LuisErnie/Pico-Bot/README.md

# Pico-Bot
Raspberry Pi RP2040 Based Robotics Controller
