LuisErnie/Pico-Bot/KiCAD design files/QR.png

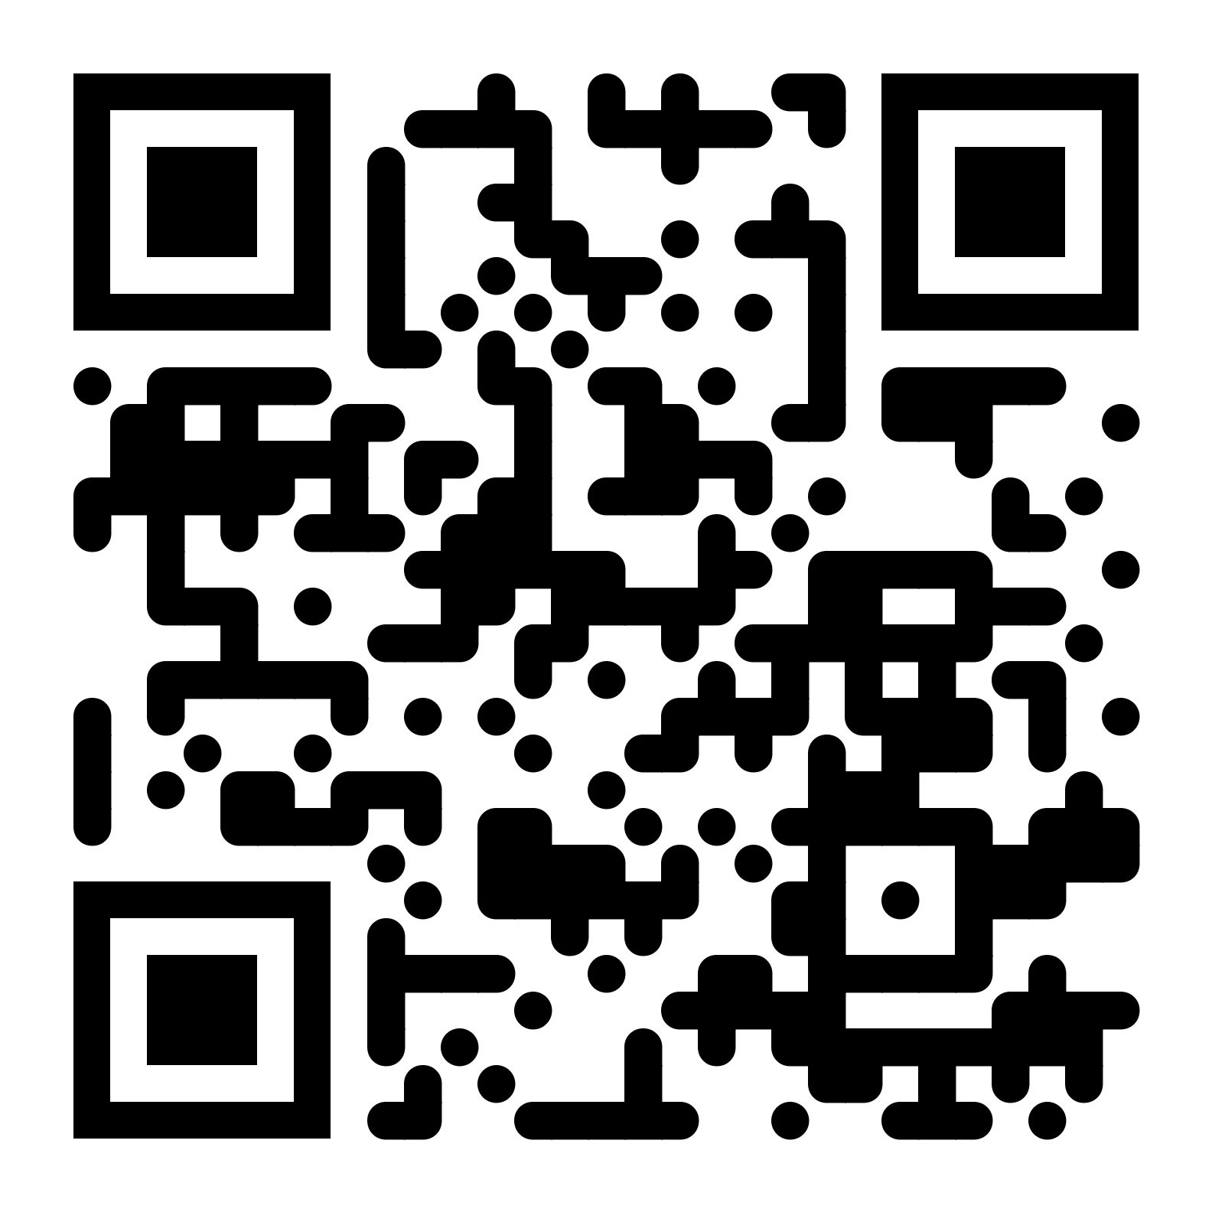
KiCAD design files/QR.png
