LuisErnie/Pico-Bot/KiCAD design files/Table 2.png

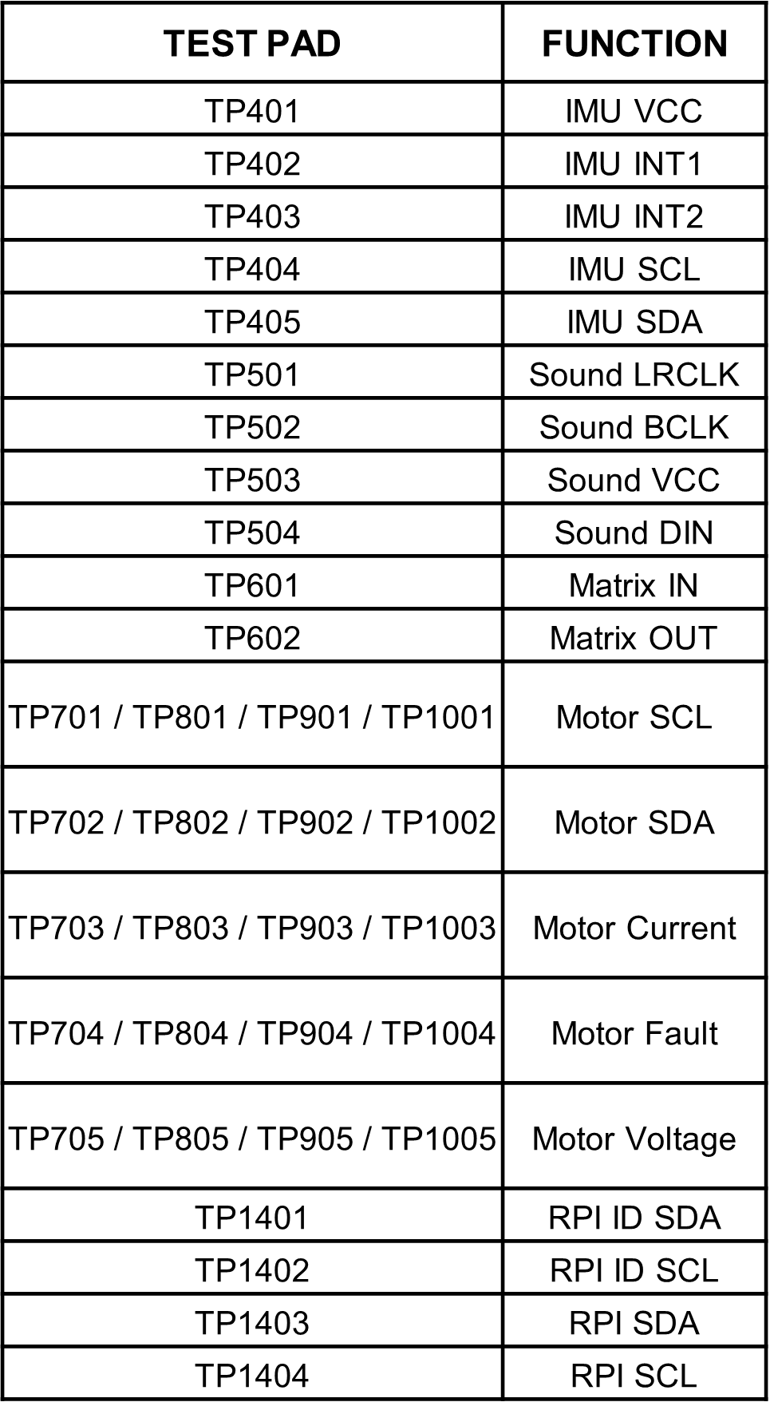
KiCAD design files/Table 2.png
