LuisErnie/Pico-Bot/KiCAD design files/Table.png

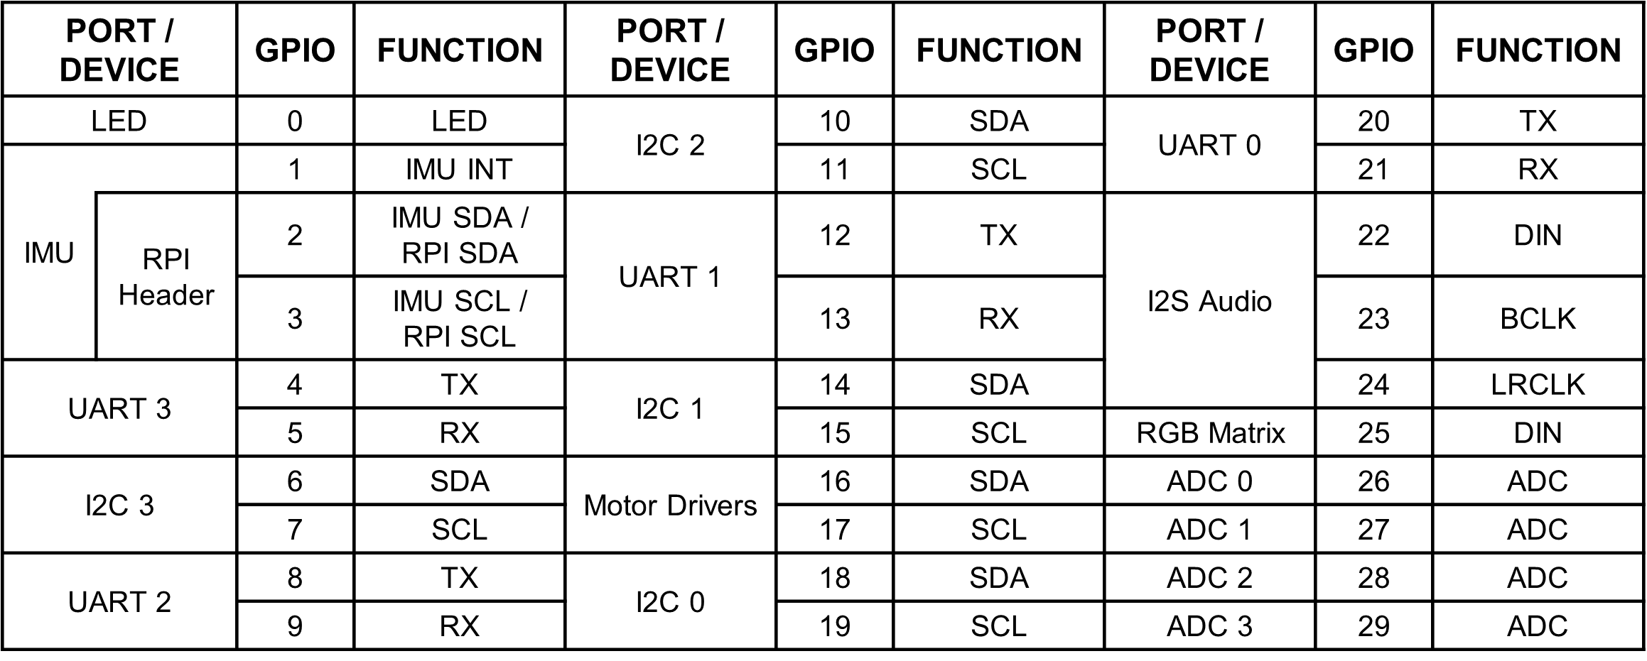
KiCAD design files/Table.png
