LuisErnie/Pico-Bot/KiCAD design files/BOM.xlsx

Customer Part Number(optional) | Manufacture Part Number | Qty | Qty TT | Value | Cmp name | Footprint | Description
J202, | XT60 | 1 | 5 | XT60-M | XT60-M | SnapEDA Library:AMASS_XT60-M
Y301, | X503212MSB2GI | 1 | 5 | Crystal 12MHz | Crystal | Crystal:Crystal_SMD_5032-2Pin_5.0x3.2mm_HandSoldering | Two pin crystal
U301, | USBLC6-2P6 | 1 | 5 | USBLC6-2P6 | USBLC6-2P6 | Package_TO_SOT_SMD:SOT-666 | Very low capacitance ESD protection diode, 2 data-line, SOT-666
J301, | TYPEC-304A-ACP16L | 1 | 5 | USB_C_Receptacle_USB2.0 | USB_C_Receptacle_USB2.0 | Connector_USB:USB_C_Receptacle_XKB_U262-16XN-4BVC11 | USB 2.0-only Type-C Receptacle connector
F202, F203, F204, F205, | SMD1812-300C-16V | 4 | 20 | Polyfuse | Polyfuse | Fuse:Fuse_1812_4532Metric | Resettable fuse, polymeric positive temperature coefficient
F201 | SMD1812-110C-16V | 1 | 5 | Polyfuse | Polyfuse | Fuse:Fuse_1812_4532Metric | Resettable fuse, polymeric positive temperature coefficient
R205, | RC0603FR-071M91L | 1 | 5 | R_UP | R_US | Resistor_SMD:R_0603_1608Metric_Pad0.98x0.95mm_HandSolder | Resistor, US symbol
R717, R817, R917, R1017, | RC-02W3302FT | 4 | 20 | 33k | R_US | Resistor_SMD:R_0402_1005Metric_Pad0.72x0.64mm_HandSolder | Resistor, US symbol
R706, R806, R906, R1006, | RC-02W3300FT | 4 | 20 | 330E | R_US | Resistor_SMD:R_0402_1005Metric_Pad0.72x0.64mm_HandSolder | Resistor, US symbol
J1401, | PH-00650 | 1 | 5 | Raspberry_Pi_2_3 | Raspberry_Pi_2_3 | Connector_PinHeader_2.54mm:PinHeader_2x20_P2.54mm_Vertical_SMD | expansion header for Raspberry Pi 2 & 3
D301, D302, D303, D304, D701, D702, D703, D704, D801, D802, D803, D804, D901, D902, D903, D904, D1001, D1002, D1003, D1004, | PESD3V3L1BA,115 | 20 | 100 | PESD3V3L1BA | D_TVS | Diode_SMD:D_SOD-323 | Bidirectional transient-voltage-suppression diode
U703, U803, U903, U1003, U1101, U1102, U1103, U1104, U1201, U1202, U1203, U1204, | MCP6001T-I/OT | 12 | 60 | MCP6001x-LT | MCP6001x-LT | Package_TO_SOT_SMD:SOT-23-5_HandSoldering | 1 MHz, Low-Power Op Amp, SC-70-5
U201, U202, | LTC4412ES6#TRPBF | 2 | 10 | LTC4412xS6 | LTC4412xS6 | Package_TO_SOT_SMD:TSOT-23-6 | Low Loss PowerPath Controller, TSOT-23-6
J1317, J1318, J1319, J1320, | KF141R-2.54-2P | 4 | 8 | 691402910002B | 691402910002B | SnapEDA Library:691402910002B
C303, C311, C313, C315, | GRM155R61E225KE11D | 4 | 20 | 2.2uF | C | Capacitor_SMD:C_0402_1005Metric_Pad0.74x0.62mm_HandSolder | Unpolarized capacitor
R301, R302, | FRC0402F5101TS | 2 | 10 | 5k1 | R_US | Resistor_SMD:R_0402_1005Metric_Pad0.72x0.64mm_HandSolder | Resistor, US symbol
R308, R309, R310, R701, R702, R705, R801, R802, R805, R901, R902, R903, R1001, R1002, R1003, | FRC0402F49R9TS | 15 | 75 | 50E | R_US | Resistor_SMD:R_0402_1005Metric_Pad0.72x0.64mm_HandSolder | Resistor, US symbol
R202, R203, | FRC0402F4703TS | 2 | 10 | 470k | R_US | Resistor_SMD:R_0402_1005Metric_Pad0.72x0.64mm_HandSolder | Resistor, US symbol
R1401, R1402, | FRC0402F3901TS | 2 | 10 | 3k9 | R_US | Resistor_SMD:R_0402_1005Metric_Pad0.72x0.64mm_HandSolder | Resistor, US symbol
R303, | FRC0402F2000TS | 1 | 5 | 200E | R_US | Resistor_SMD:R_0402_1005Metric_Pad0.72x0.64mm_HandSolder | Resistor, US symbol
R305, | FRC0402F1R00TS | 1 | 5 | 1E | R_US | Resistor_SMD:R_0402_1005Metric_Pad0.72x0.64mm_HandSolder | Resistor, US symbol
R501, | FRC0402F1004TS | 1 | 5 | 1M | R_US | Resistor_SMD:R_0402_1005Metric_Pad0.72x0.64mm_HandSolder | Resistor, US symbol
R502, R506, R714, R718, R814, R818, R914, R918, R1014, R1018, | FRC0402F1003TS | 10 | 50 | 100k | R_US | Resistor_SMD:R_0402_1005Metric_Pad0.72x0.64mm_HandSolder | Resistor, US symbol
R304, R313, R401, R402, R403, R703, R704, R709, R710, R711, R712, R713, R716, R719, R720, R803, R804, R809, R810, R811, R812, R813, R816, R819, R820, R904, R905, R909, R910, R911, R912, R913, R916, R919, R920, R1004, R1005, R1009, R1010, R1011, R1012, R1013, R1016, R1019, R1020, | FRC0402F1002TS | 45 | 225 | 10k | R_US | Resistor_SMD:R_0402_1005Metric_Pad0.72x0.64mm_HandSolder | Resistor, US symbol
R201, R312, R314, R315, R1403, | FRC0402F1001TS | 5 | 25 | 1k | R_US | Resistor_SMD:R_0402_1005Metric_Pad0.72x0.64mm_HandSolder | Resistor, US symbol
R404, R405, R503, R504, R505, R707, R708, R715, R807, R808, R815, R907, R908, R915, R1007, R1008, R1015, R1101, R1102, R1103, R1104, R1201, R1202, R1203, R1204, | FRC0402F0000TS | 25 | 125 | 0E | R_US | Resistor_SMD:R_0402_1005Metric_Pad0.72x0.64mm_HandSolder | Resistor, US symbol
FB202, | FBMA-11-453215-900A60T | 1 | 5 | FerriteBead (7427932) | FerriteBead | Inductor_SMD:L_1812_4532Metric | Ferrite bead
S201, | EG1213 | 1 | 5 | EG1213 | EG1213 | SnapEDA Library:SW_EG1213
C203, | EEEFC1E220AP | 1 | 5 | 22uF 10V | C_Polarized_US | Capacitor_SMD:CP_Elec_4x5.4 | Polarized capacitor, US symbol
C201, C202, | EEE1VA100WAR | 6 | 30 | 10uF 25V | C_Polarized_US | Capacitor_SMD:CP_Elec_4x5.4 | Polarized capacitor, US symbol
J201, | DC-050-25A | 1 | 5 | Barrel_Jack_Switch | Barrel_Jack_Switch | Connector_BarrelJack:BarrelJack_CLIFF_FC681465S_SMT_Horizontal | DC Barrel Jack with an internal switch
J102, | CS-1165SDIG-1*3 | 1 | 5 | Conn_01x03_Female | Conn_01x03_Female | Connector_PinSocket_2.54mm:PinSocket_1x03_P2.54mm_Vertical | Generic connector, single row, 01x03, script generated (kicad-library-utils/schlib/autogen/connector/)
L301, | CMF3216F-900M-2P-T | 1 | 5 | EMTEK CMF3216F-900M-2P-T | L_Iron_Coupled | SnapEDA Library:FIL_SRF3216-222Y | Coupled inductor with iron core
C501, | CL05A106MP5NUNC | 1 | 5 | 10uF | C | Capacitor_SMD:C_0402_1005Metric_Pad0.74x0.62mm_HandSolder | Unpolarized capacitor
FB501, FB502, FB701, FB801, FB901, FB1001, FB1101, FB1102, FB1103, FB1104, FB1201, FB1202, FB1203, FB1204, | CBW201209U101T | 14 | 70 | FerriteBead | FerriteBead | Inductor_SMD:L_0805_2012Metric | Ferrite bead
FB201, | BCMS453215A7006A | 1 | 5 | FerriteBead (742792510) | FerriteBead | Inductor_SMD:L_1812_4532Metric | Ferrite bead
Q201, Q202, | AO4805 | 2 | 10 | SI4925BDY | SI4925BDY | SnapEDA Library:SO-8
J101, | 12251103CNG0S115001 | 1 | 5 | Conn_01x03_Male | Conn_01x03_Male | Connector_PinHeader_2.54mm:PinHeader_1x03_P2.54mm_Vertical | Generic connector, single row, 01x03, script generated (kicad-library-utils/schlib/autogen/connector/)
R207, | 0603WAF3404T5E | 1 | 5 | R_DOWN | R_US | Resistor_SMD:R_0603_1608Metric_Pad0.98x0.95mm_HandSolder | Resistor, US symbol
R306, R307, | 0402WGF270JTCE | 2 | 10 | 27E | R_US | Resistor_SMD:R_0402_1005Metric_Pad0.72x0.64mm_HandSolder | Resistor, US symbol
R721, R821, R921, R1021, | 0402WGF200LTCE | 4 | 20 | 0.2E | R_US | Resistor_SMD:R_0402_1005Metric_Pad0.72x0.64mm_HandSolder | Resistor, US symbol
C503, C504, | 0402N221J500CT | 2 | 10 | 220pF | C | Capacitor_SMD:C_0402_1005Metric_Pad0.74x0.62mm_HandSolder | Unpolarized capacitor
C316, C317, | 0402N150F500CT | 2 | 10 | 15pF | C | Capacitor_SMD:C_0402_1005Metric_Pad0.74x0.62mm_HandSolder | Unpolarized capacitor
C301, C302, C304, C305, C306, C307, C308, C309, C310, C312, C314, C401, C402, C502, C601, C602, C603, C604, C605, C606, C607, C608, C609, C610, C611, C612, C613, C614, C615, C616, C617, C618, C619, C620, C621, C622, C623, C624, C625, C701, C704, C705, C706, C708, C801, C804, C805, C806, C808, C901, C904, C905, C906, C908, C1001, C1004, C1005, C1006, C1008, C1101, C1102, C1105, C1108, C1201, C1202, C1205, C1208, C1401, | 0402B104J160CT | 68 | 340 | 0.1uF | C | Capacitor_SMD:C_0402_1005Metric_Pad0.74x0.62mm_HandSolder | Unpolarized capacitor
C702, C802, C902, C1002, | 0402B103J500CT | 4 | 20 | 10nF | C | Capacitor_SMD:C_0402_1005Metric_Pad0.74x0.62mm_HandSolder | Unpolarized capacitor
C709, C809, C909, C1009, | 0402B102J500CT | 4 | 20 | 1000pF | C | Capacitor_SMD:C_0402_1005Metric_Pad0.74x0.62mm_HandSolder | Unpolarized capacitor
C707, C807, C907, C1007, C1103, C1104, C1106, C1107, C1203, C1204, C1206, C1207, | - | 12 | 0 | NP | C | Capacitor_SMD:C_0603_1608Metric_Pad1.08x0.95mm_HandSolder | Unpolarized capacitor
D201, D305, | - | 2 | 0 | LED | LED | LED_SMD:LED_0805_2012Metric | Light emitting diode
D601, D602, D603, D604, D605, D606, D607, D608, D609, D610, D611, D612, D613, D614, D615, D616, D617, D618, D619, D620, D621, D622, D623, D624, D625, | - | 25 | 0 | WS2812B | WS2812B | LED_SMD:LED_WS2812B_PLCC4_5.0x5.0mm_P3.2mm | RGB LED with integrated controller
J1301, J1302, J1303, J1304, J1305, J1306, J1307, J1308, J1309, J1310, J1311, J1312, J1313, J1314, J1315, J1316, | - | 16 | 0 | 114020164 | 114020164 | 114020164:114020164
J501, | - | 1 | 0 | Conn_01x02_Male | Conn_01x02_Male | Connector_JST:JST_XH_B2B-XH-A_1x02_P2.50mm_Vertical | Generic connector, single row, 01x02, script generated (kicad-library-utils/schlib/autogen/connector/)
SW301, SW302, | - | 2 | 0 | SW_SPST | SW_SPST | Button_Switch_SMD:SW_SPST_TL3342 | Single Pole Single Throw (SPST) switch
U1401, | - | 1 | 0 | 24LC32 | 24LC32 | Package_SO:TSSOP-8_4.4x3mm_P0.65mm | I2C Serial EEPROM, 32Kb, DIP-8/SOIC-8/TSSOP-8/DFN-8
U203, | - | 1 | 0 | RPM3.3-2.0 | RPM3.3-2.0 | Converter_DCDC:Converter_DCDC_RECOM_RPMx.x-x.0 | 2A non-isolated switching regulator power module, 3-17V input voltage, 3.3V output voltage, DOSA
U302, | - | 1 | 0 | RP2040 | RP2040 | SnapEDA Library:QFN40P700X700X90-57N
U303, | - | 1 | 0 | W25Q128JVS | W25Q128JVS | Package_SO:SOIC-8_5.23x5.23mm_P1.27mm | 128Mb Serial Flash Memory, Standard/Dual/Quad SPI, SOIC-8
U401, | - | 1 | 0 | LSM6DS3 | LSM6DS3 | Package_LGA:LGA-14_3x2.5mm_P0.5mm_LayoutBorder3x4y | I2C/SPI, iNEMO inertial module: always-on 3D accelerometer and 3D gyroscope
U501, | - | 1 | 0 | MAX98357AETE+ | MAX98357AETE+ | SnapEDA Library:QFN50P300X300X80-17N
U701, U801, U901, U1001, | - | 4 | 0 | ATtiny1627 | ATtiny1627 | Package_DFN_QFN:QFN-24-1EP_4x4mm_P0.5mm_EP2.7x2.7mm
U702, U802, U902, U1002, | - | 4 | 0 | DRV8801PWP | DRV8801PWP | Package_SO:HTSSOP-16-1EP_4.4x5mm_P0.65mm_EP3.4x5mm_Mask3x3mm_ThermalVias | H-Bridge Motor Driver, TSSOP-16
