LuisErnie/Pico-Bot/KiCAD design files/PicoBot.kicad_sch

## KiCad design KiCAD design files/PicoBot.kicad_sch (2022-05-06)

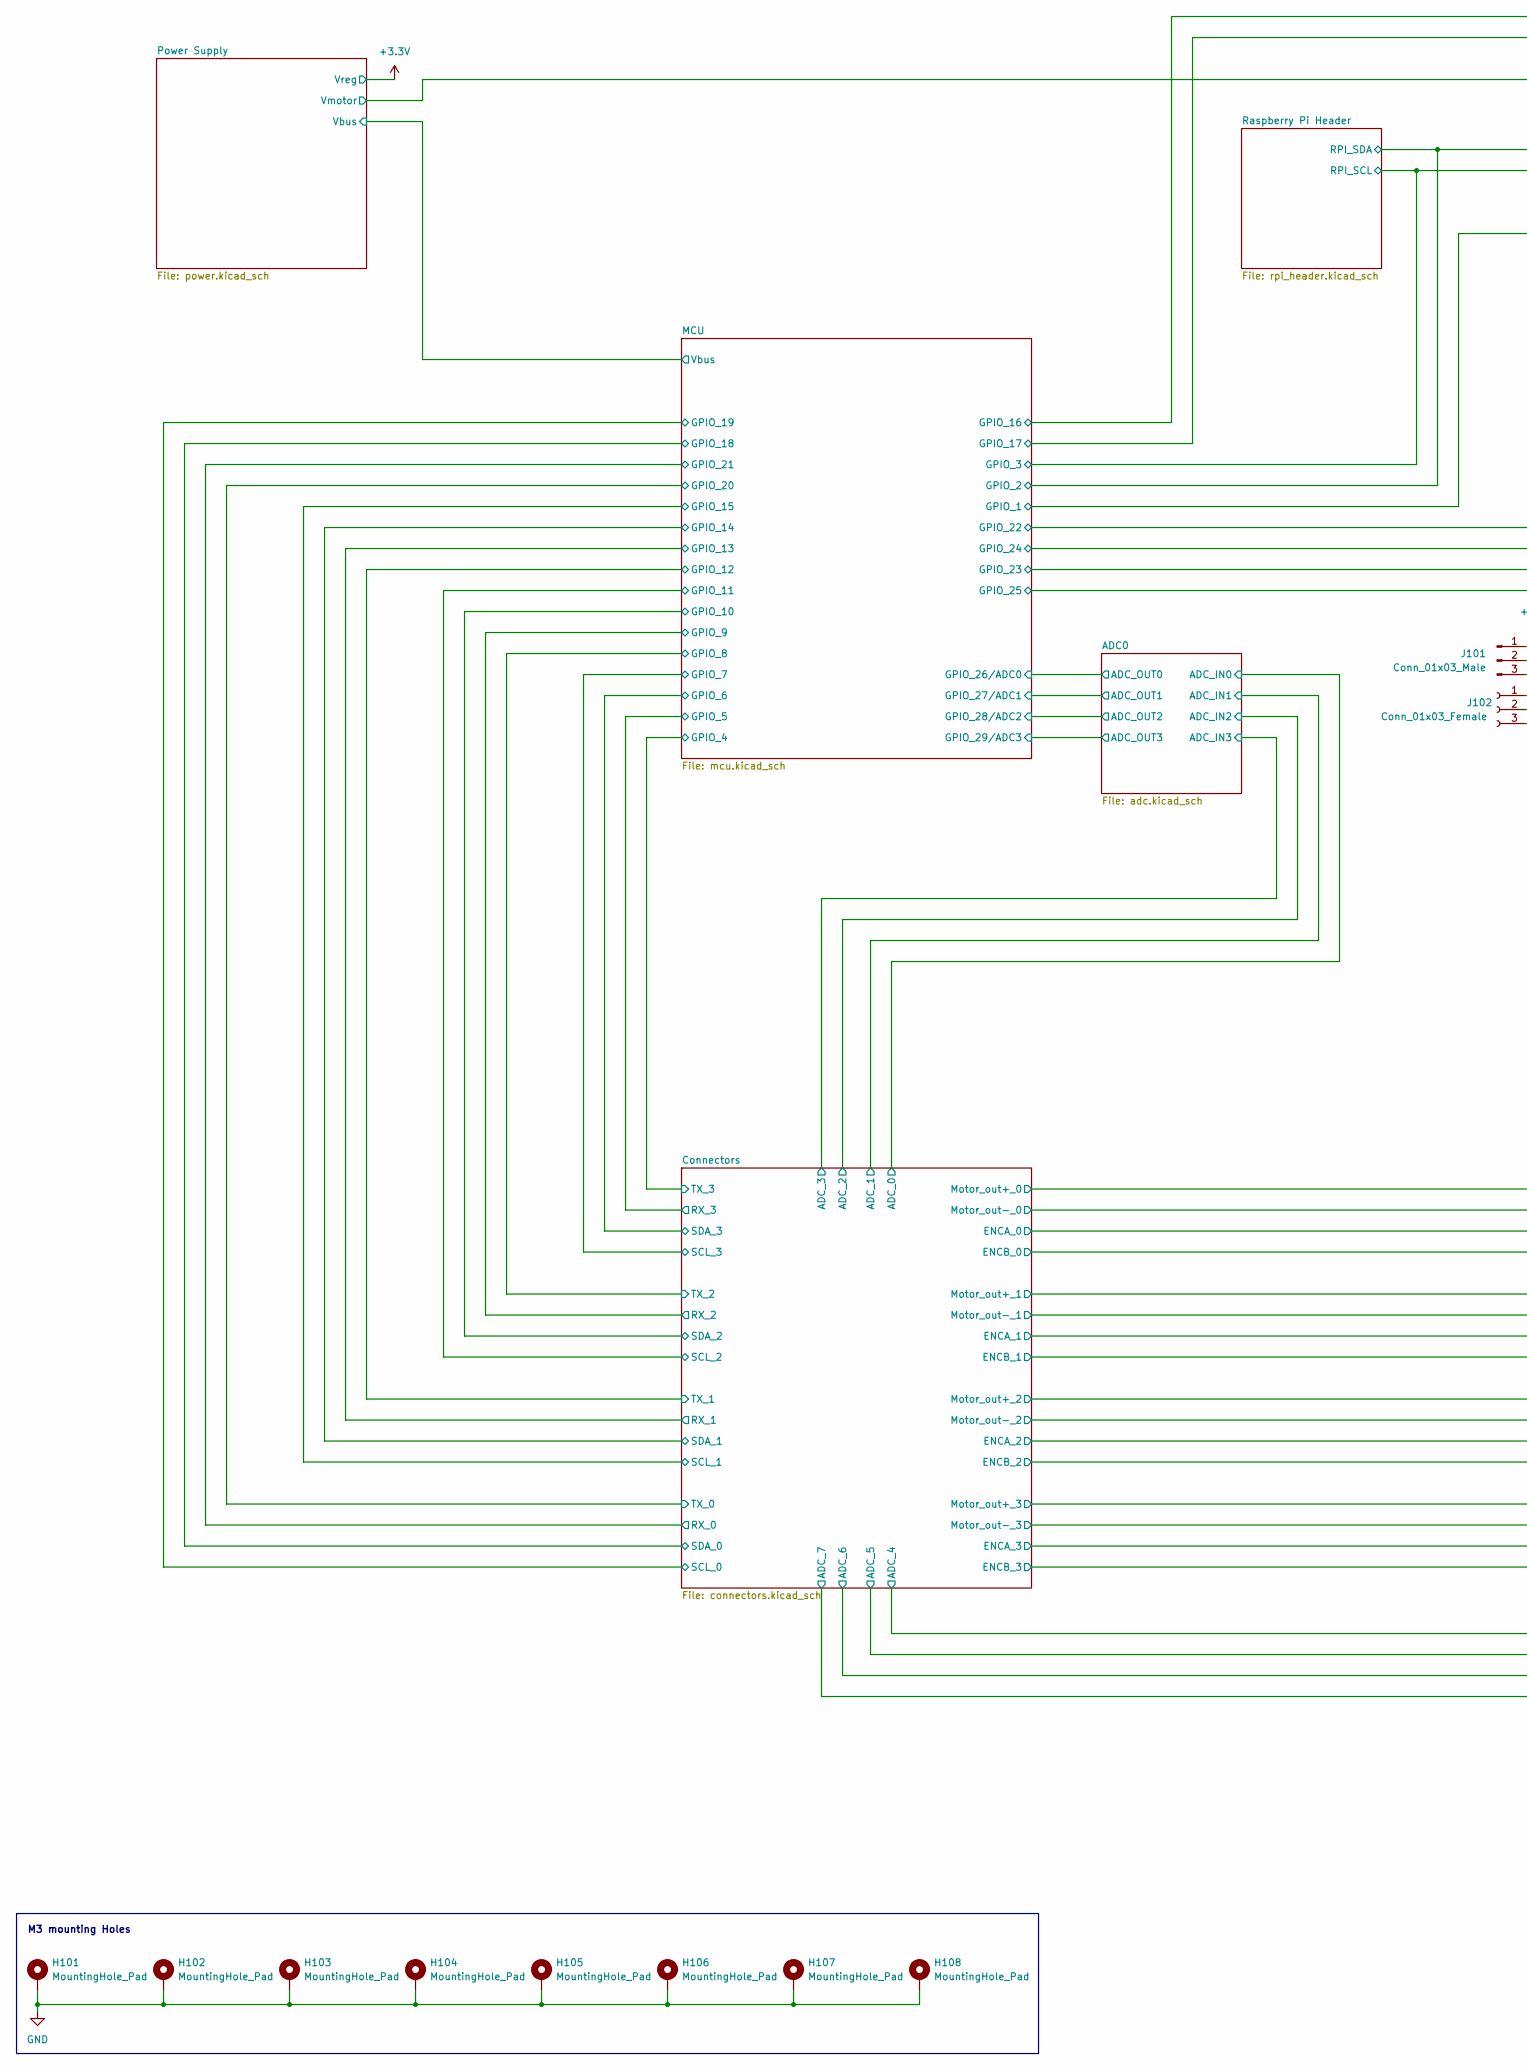
[picture p4: schematic PicoBot.kicad_sch, part in row 1, column 1]

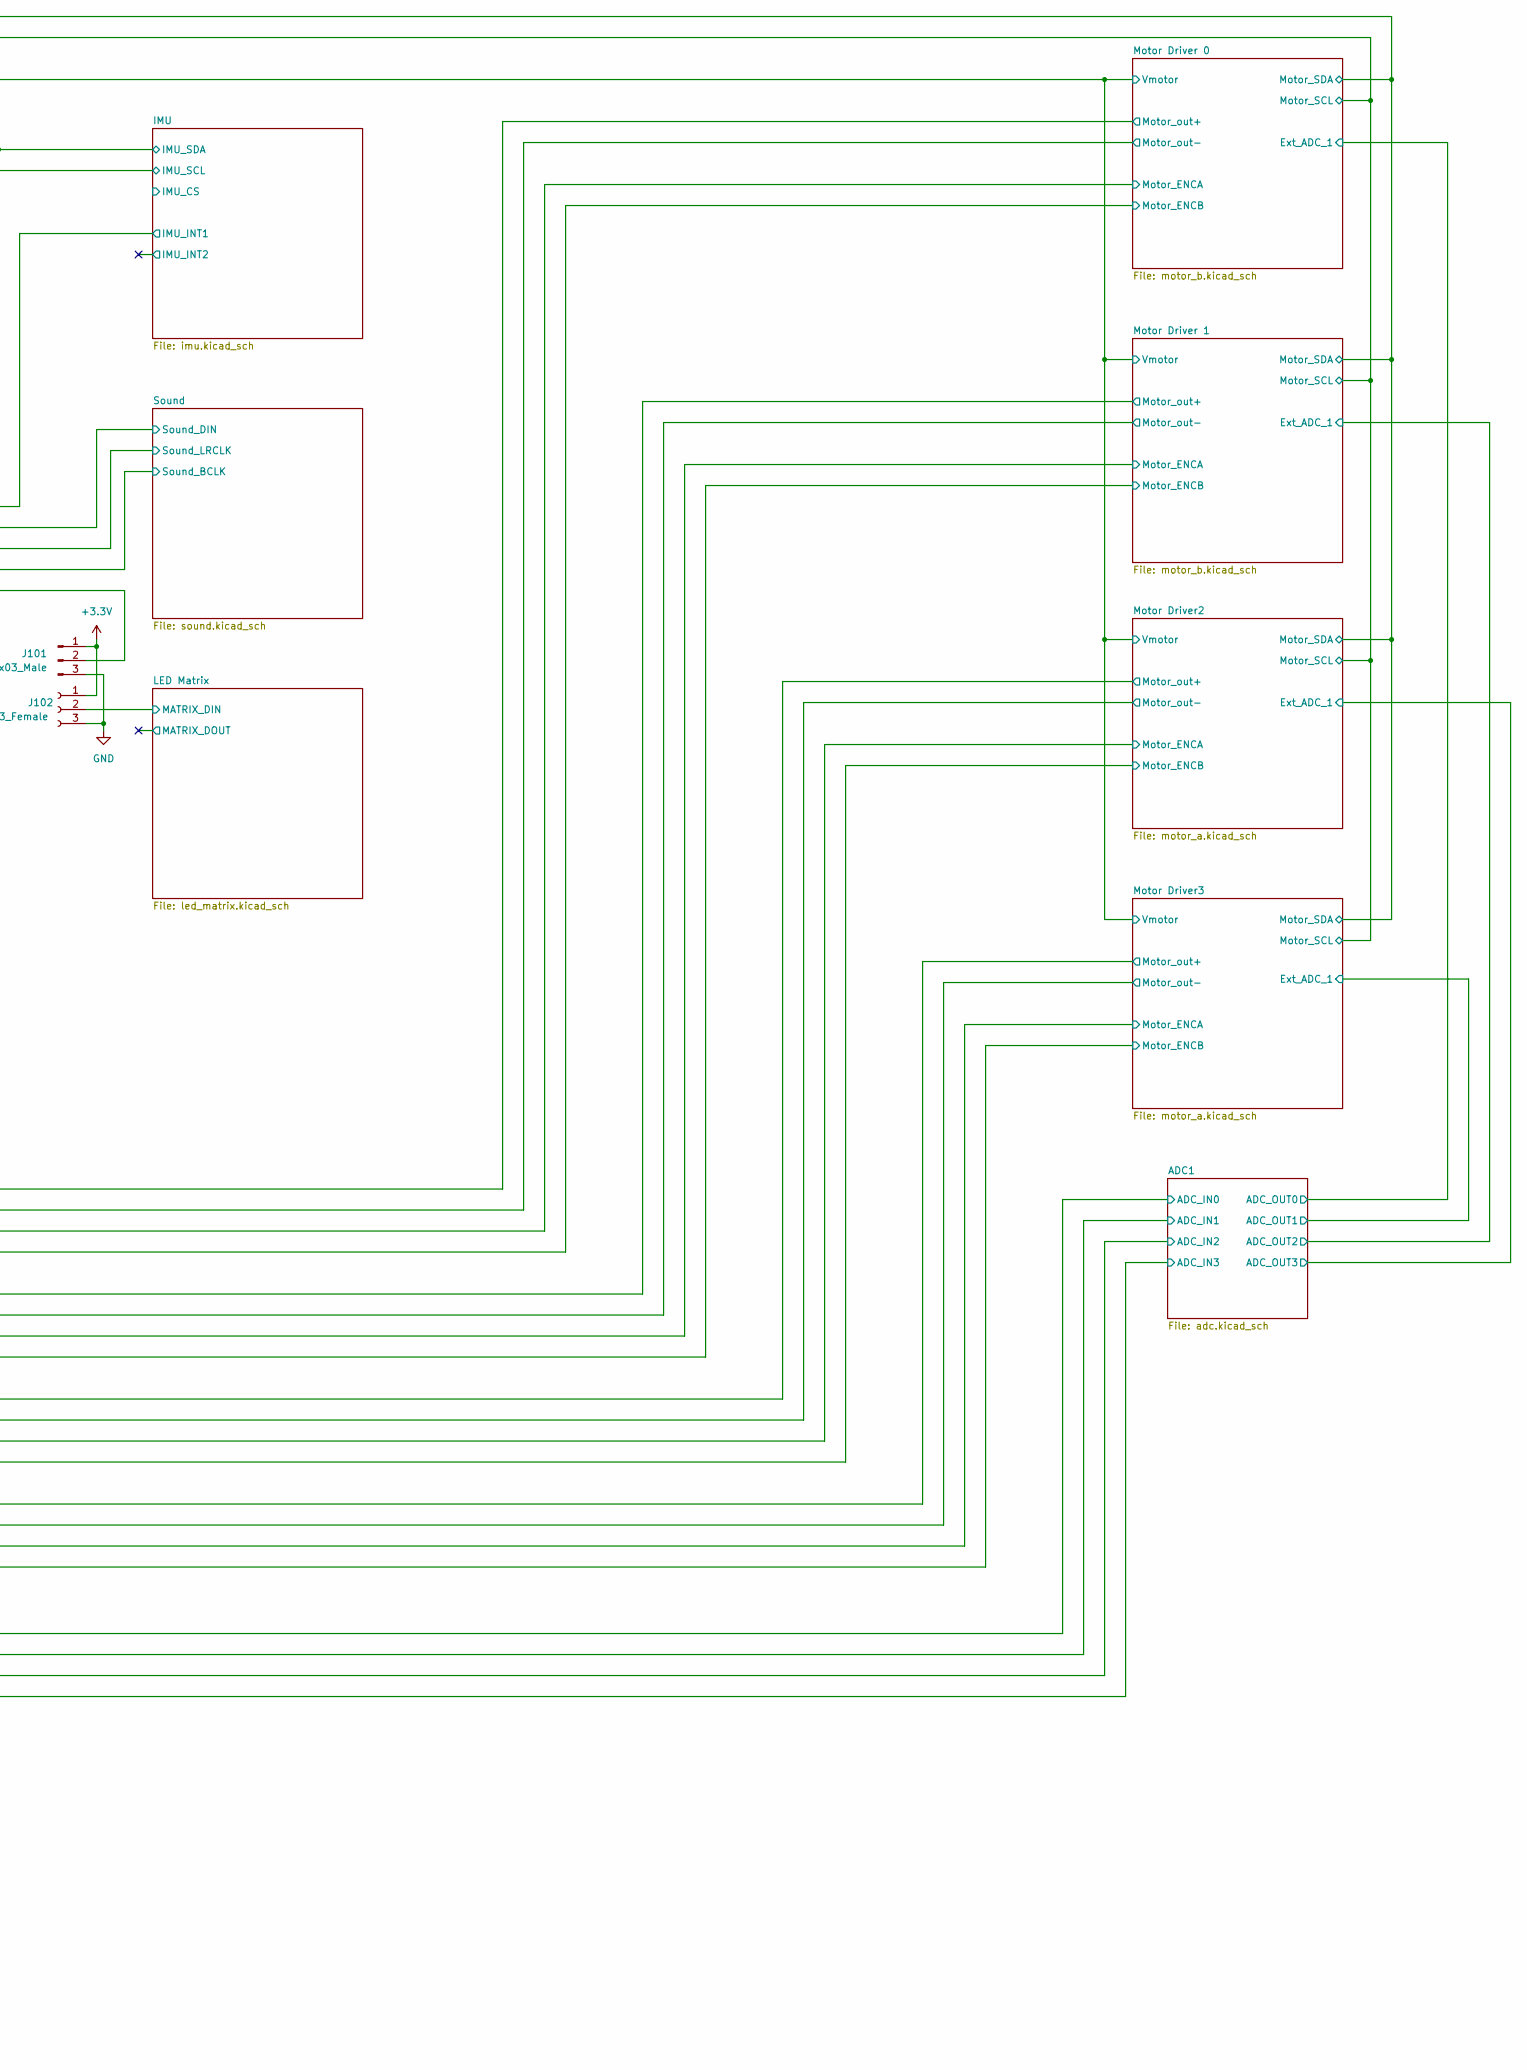
[picture p5: schematic PicoBot.kicad_sch, part in row 1, column 2]

Parts:
H101, H102, H103, H104, H105, H106, H107, H108: MountingHole_Pad; MountingHole_3.2mm_M3_Pad_Via
J101: Conn_01x03_Male; PinHeader_1x03_P2.54mm_Vertical
J102: Conn_01x03_Female; PinSocket_1x03_P2.54mm_Vertical

Connections:
+3.3V: J101.1, J102.1
GND: H101.1, H102.1, H103.1, H104.1, H105.1, H106.1, H107.1, H108.1, J101.3, J102.3
GPIO_25: J101.2
MATRIX_DIN: J102.2

Notes on the sheet:
M3 mounting Holes
