LuisErnie/Pico-Bot/KiCAD design files/adc.kicad_sch

## KiCad design KiCAD design files/adc.kicad_sch (2022-05-06)

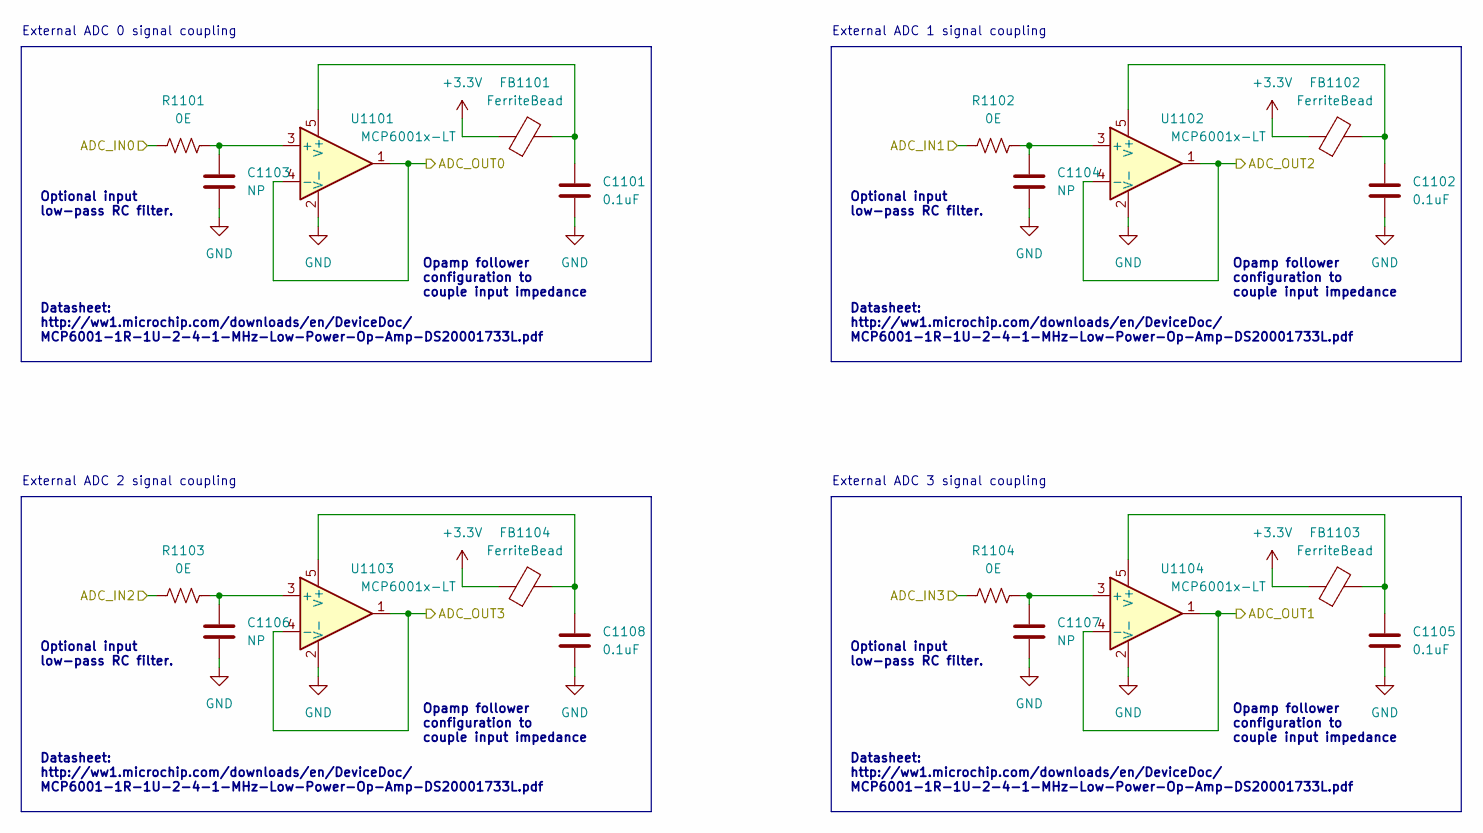
[picture p6: schematic adc.kicad_sch]

Parts:
C1101, C1102, C1105, C1108: 0.1uF; C_0402_1005Metric_Pad0.74x0.62mm_HandSolder
C1103, C1104, C1106, C1107: NP; C_0603_1608Metric_Pad1.08x0.95mm_HandSolder
FB1101, FB1102, FB1103, FB1104: FerriteBead; L_0805_2012Metric
R1101, R1102, R1103, R1104: 0E; R_0402_1005Metric_Pad0.72x0.64mm_HandSolder
U1101, U1102, U1103, U1104: MCP6001x-LT; SOT-23-5_HandSoldering

Connections:
+3.3V: FB1101.1, FB1102.1, FB1103.1, FB1104.1
ADC_IN0: R1101.1
ADC_IN1: R1102.1
ADC_IN2: R1103.1
ADC_IN3: R1104.1
ADC_OUT0: U1101.1, U1101.4 (-)
ADC_OUT1: U1104.1, U1104.4 (-)
ADC_OUT2: U1102.1, U1102.4 (-)
ADC_OUT3: U1103.1, U1103.4 (-)
GND: C1101.2, C1102.2, C1103.2, C1104.2, C1105.2, C1106.2, C1107.2, C1108.2, U1101.2 (V-), U1102.2 (V-), U1103.2 (V-), U1104.2 (V-)
unnamed: C1101.1, FB1101.2, U1101.5 (V+)
unnamed: C1102.1, FB1102.2, U1102.5 (V+)
unnamed: C1103.1, R1101.2, U1101.3 (+)
unnamed: C1104.1, R1102.2, U1102.3 (+)
unnamed: C1105.1, FB1103.2, U1104.5 (V+)
unnamed: C1106.1, R1103.2, U1103.3 (+)
unnamed: C1107.1, R1104.2, U1104.3 (+)
unnamed: C1108.1, FB1104.2, U1103.5 (V+)

Notes on the sheet:
Opamp follower configuration to couple input impedance
Datasheet: http://ww1.microchip.com/downloads/en/DeviceDoc/ MCP6001-1R-1U-2-4-1-MHz-Low-Power-Op-Amp-DS20001733L.pdf
Optional input low-pass RC filter.
External ADC 1 signal coupling
External ADC 2 signal coupling
External ADC 0 signal coupling
External ADC 3 signal coupling
