LuisErnie/Pico-Bot/KiCAD design files/connectors.kicad_sch

## KiCad design KiCAD design files/connectors.kicad_sch (2022-05-06)

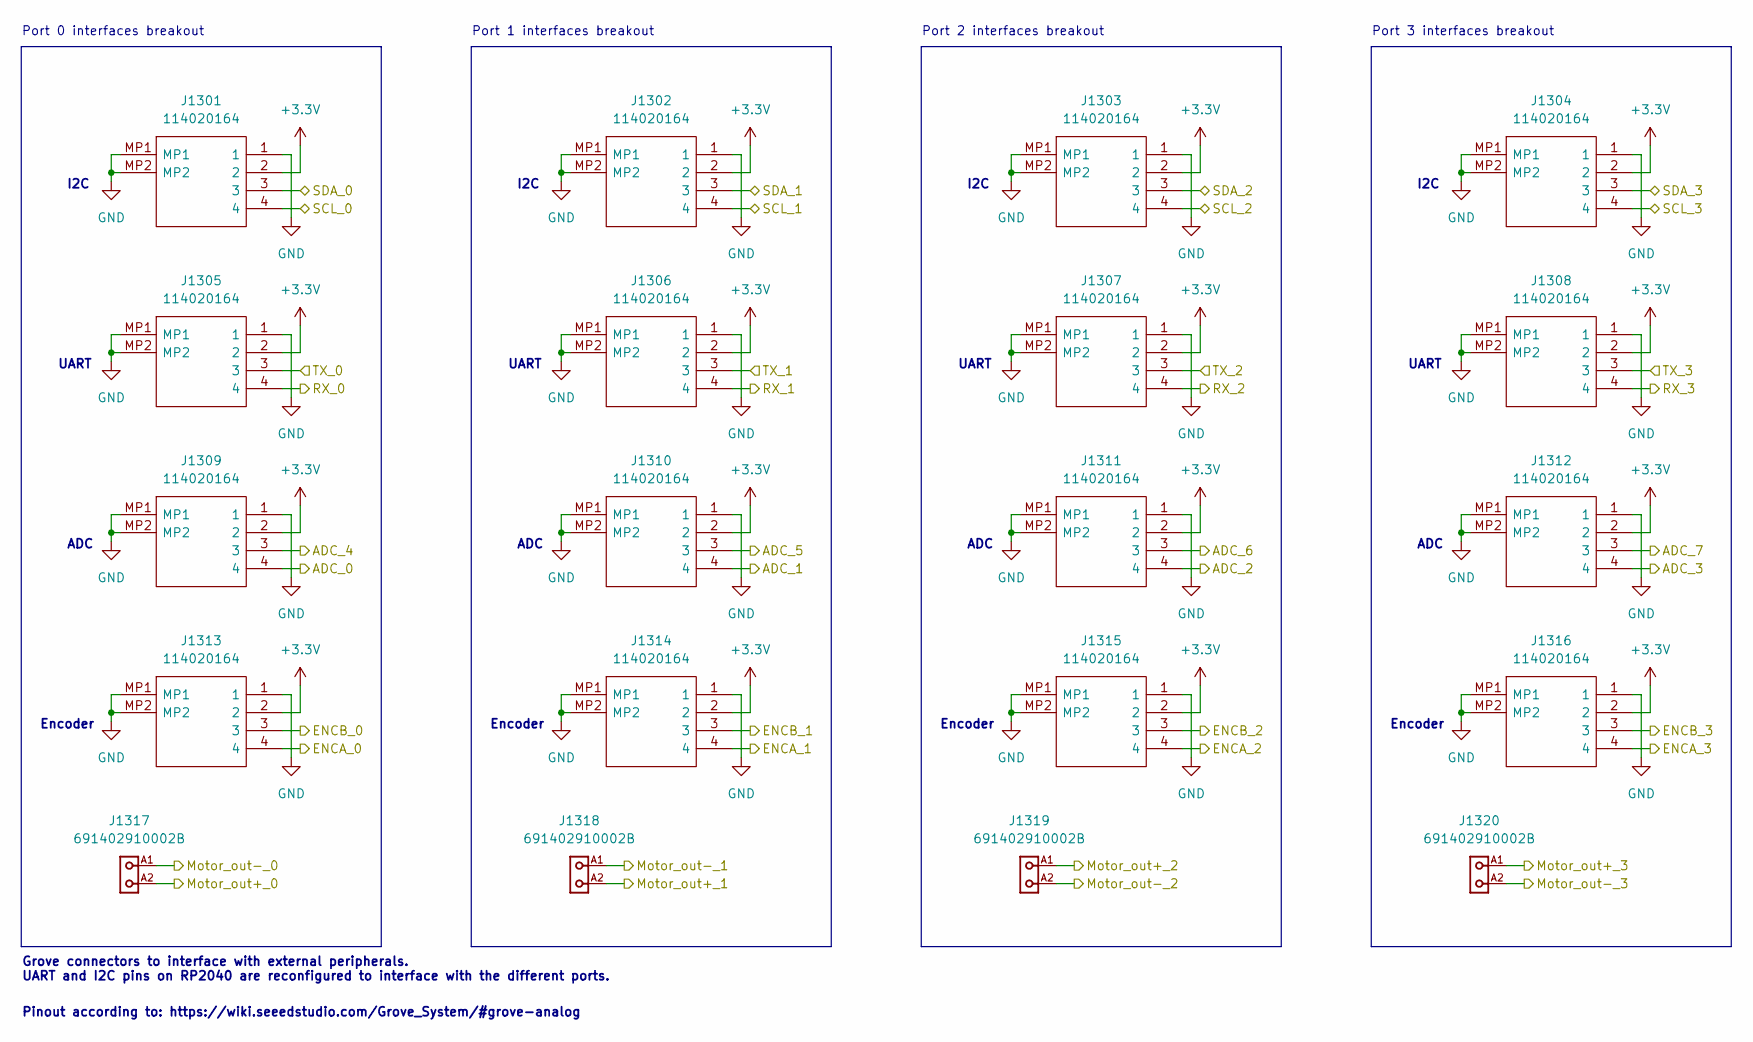
[picture p7: schematic connectors.kicad_sch]

Parts:
J1301, J1302, J1303, J1304, J1305, J1306, J1307, J1308, J1309, J1310, J1311, J1312, J1313, J1314, J1315, J1316: 114020164; Manufacturer_Part_Number 114020164; Mouser Part Number 713-114020164
J1317, J1318, J1319, J1320: 691402910002B; PART-NUMBER 691402910002B

Connections:
+3.3V: J1301.2, J1302.2, J1303.2, J1304.2, J1305.2, J1306.2, J1307.2, J1308.2, J1309.2, J1310.2, J1311.2, J1312.2, J1313.2, J1314.2, J1315.2, J1316.2
ADC_0: J1309.4
ADC_1: J1310.4
ADC_2: J1311.4
ADC_3: J1312.4
ADC_4: J1309.3
ADC_5: J1310.3
ADC_6: J1311.3
ADC_7: J1312.3
ENCA_0: J1313.4
ENCA_1: J1314.4
ENCA_2: J1315.4
ENCA_3: J1316.4
ENCB_0: J1313.3
ENCB_1: J1314.3
ENCB_2: J1315.3
ENCB_3: J1316.3
GND: J1301.1, J1301.MP1, J1301.MP2, J1302.1, J1302.MP1, J1302.MP2, J1303.1, J1303.MP1, J1303.MP2, J1304.1, J1304.MP1, J1304.MP2, J1305.1, J1305.MP1, J1305.MP2, J1306.1, J1306.MP1, J1306.MP2, J1307.1, J1307.MP1, J1307.MP2, J1308.1, J1308.MP1, J1308.MP2, J1309.1, J1309.MP1, J1309.MP2, J1310.1, J1310.MP1, J1310.MP2, J1311.1, J1311.MP1, J1311.MP2, J1312.1, J1312.MP1, J1312.MP2, J1313.1, J1313.MP1, J1313.MP2, J1314.1, J1314.MP1, J1314.MP2, J1315.1, J1315.MP1, J1315.MP2, J1316.1, J1316.MP1, J1316.MP2
Motor_out+_0: J1317.A2
Motor_out+_1: J1318.A2
Motor_out+_2: J1319.A1
Motor_out+_3: J1320.A1
Motor_out-_0: J1317.A1
Motor_out-_1: J1318.A1
Motor_out-_2: J1319.A2
Motor_out-_3: J1320.A2
RX_0: J1305.4
RX_1: J1306.4
RX_2: J1307.4
RX_3: J1308.4
SCL_0: J1301.4
SCL_1: J1302.4
SCL_2: J1303.4
SCL_3: J1304.4
SDA_0: J1301.3
SDA_1: J1302.3
SDA_2: J1303.3
SDA_3: J1304.3
TX_0: J1305.3
TX_1: J1306.3
TX_2: J1307.3
TX_3: J1308.3

Notes on the sheet:
Port 1 interfaces breakout
ADC
Port 0 interfaces breakout
Encoder
I2C
Port 2 interfaces breakout
Grove connectors to interface with external peripherals. UART and I2C pins on RP2040 are reconfigured to interface with the different ports.
Port 3 interfaces breakout
Pinout according to: https://wiki.seeedstudio.com/Grove_System/#grove-analog
UART
