LuisErnie/Pico-Bot/KiCAD design files/imu.kicad_sch

## KiCad design KiCAD design files/imu.kicad_sch (2022-05-06)

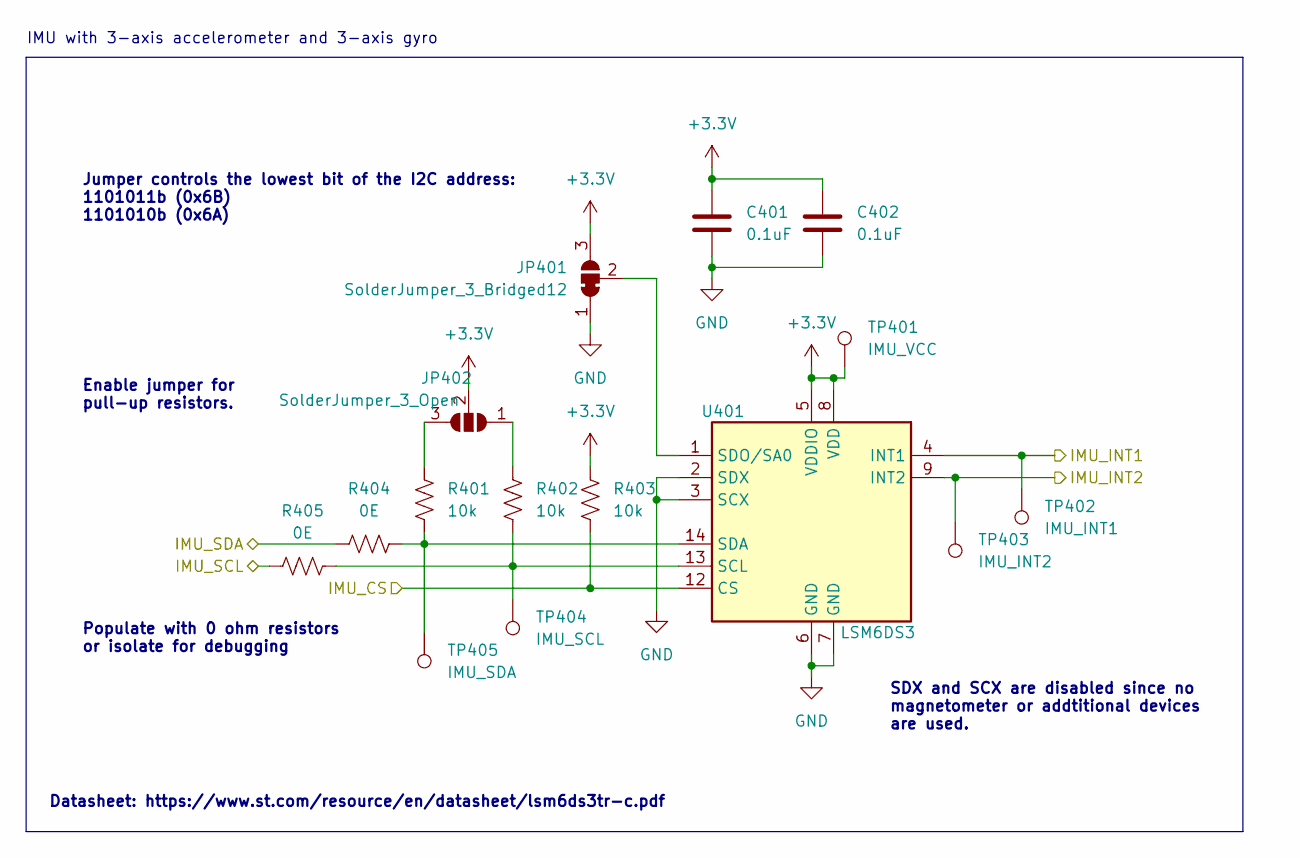
[picture p8: schematic imu.kicad_sch]

Parts:
C401, C402: 0.1uF; C_0402_1005Metric_Pad0.74x0.62mm_HandSolder
JP401: SolderJumper_3_Bridged12; SolderJumper-3_P1.3mm_Bridged12_RoundedPad1.0x1.5mm
JP402: SolderJumper_3_Open; SolderJumper-3_P1.3mm_Open_RoundedPad1.0x1.5mm
R401, R402, R403: 10k; R_0402_1005Metric_Pad0.72x0.64mm_HandSolder
R404, R405: 0E; R_0402_1005Metric_Pad0.72x0.64mm_HandSolder
TP401: IMU_VCC; TestPoint_Pad_D1.0mm
TP402: IMU_INT1; TestPoint_Pad_D1.0mm
TP403: IMU_INT2; TestPoint_Pad_D1.0mm
TP404: IMU_SCL; TestPoint_Pad_D1.0mm
TP405: IMU_SDA; TestPoint_Pad_D1.0mm
U401: LSM6DS3; LGA-14_3x2.5mm_P0.5mm_LayoutBorder3x4y

Connections:
+3.3V: C401.1, C402.1, JP401.3 (B), JP402.2 (C), R403.1, TP401.1, U401.5 (VDDIO), U401.8 (VDD)
GND: C401.2, C402.2, JP401.1 (A), U401.2 (SDX), U401.3 (SCX), U401.6 (GND), U401.7 (GND)
IMU_CS: R403.2, U401.12 (CS)
IMU_INT1: TP402.1, U401.4 (INT1)
IMU_INT2: TP403.1, U401.9 (INT2)
IMU_SCL: R405.2
IMU_SDA: R404.2
unnamed: JP401.2 (C), U401.1 (SDO/SA0)
unnamed: JP402.1 (A), R402.1
unnamed: JP402.3 (B), R401.1
unnamed: R401.2, R404.1, TP405.1, U401.14 (SDA)
unnamed: R402.2, R405.1, TP404.1, U401.13 (SCL)

Notes on the sheet:
IMU with 3-axis accelerometer and 3-axis gyro
SDX and SCX are disabled since no magnetometer or addtitional devices are used.
Enable jumper for pull-up resistors.
Jumper controls the lowest bit of the I2C address: 1101011b (0x6B) 1101010b (0x6A)
Datasheet: https://www.st.com/resource/en/datasheet/lsm6ds3tr-c.pdf
Populate with 0 ohm resistors or isolate for debugging
