LuisErnie/Pico-Bot/KiCAD design files/led_matrix.kicad_sch

## KiCad design KiCAD design files/led_matrix.kicad_sch (2022-05-06)

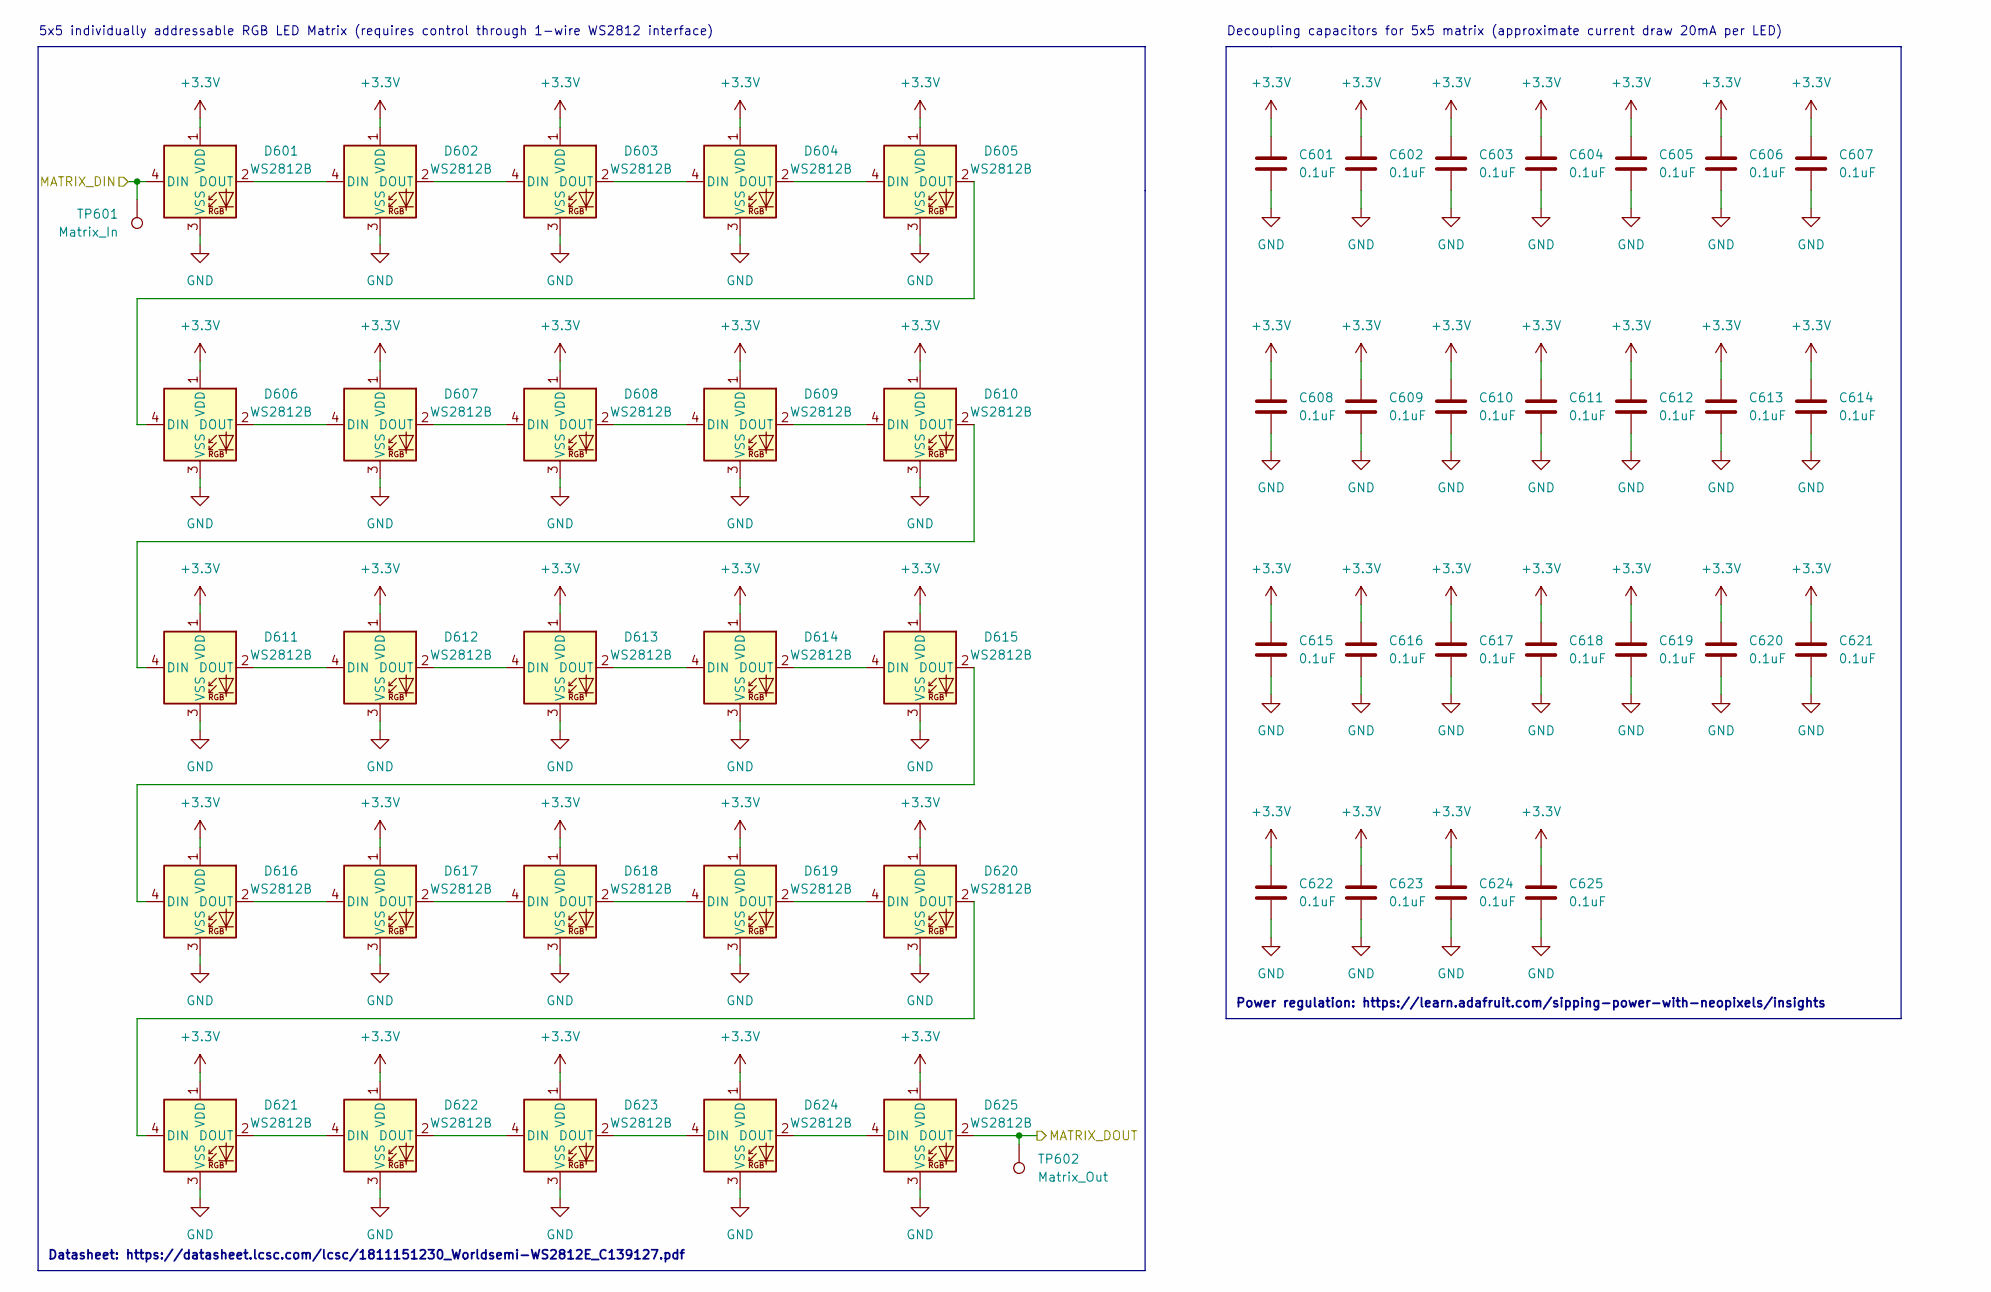
[picture p9: schematic led_matrix.kicad_sch]

Parts:
C601, C602, C603, C604, C605, C606, C607, C608, C609, C610, C611, C612, C613, C614, C615, C616, C617, C618, C619, C620, C621, C622, C623, C624, C625: 0.1uF; C_0402_1005Metric_Pad0.74x0.62mm_HandSolder
D601, D602, D603, D604, D605, D606, D607, D608, D609, D610, D611, D612, D613, D614, D615, D616, D617, D618, D619, D620, D621, D622, D623, D624, D625: WS2812B; LED_WS2812B_PLCC4_5.0x5.0mm_P3.2mm
TP601: Matrix_In; TestPoint_Pad_D1.0mm
TP602: Matrix_Out; TestPoint_Pad_D1.0mm

Connections:
+3.3V: C601.1, C602.1, C603.1, C604.1, C605.1, C606.1, C607.1, C608.1, C609.1, C610.1, C611.1, C612.1, C613.1, C614.1, C615.1, C616.1, C617.1, C618.1, C619.1, C620.1, C621.1, C622.1, C623.1, C624.1, C625.1, D601.1 (VDD), D602.1 (VDD), D603.1 (VDD), D604.1 (VDD), D605.1 (VDD), D606.1 (VDD), D607.1 (VDD), D608.1 (VDD), D609.1 (VDD), D610.1 (VDD), D611.1 (VDD), D612.1 (VDD), D613.1 (VDD), D614.1 (VDD), D615.1 (VDD), D616.1 (VDD), D617.1 (VDD), D618.1 (VDD), D619.1 (VDD), D620.1 (VDD), D621.1 (VDD), D622.1 (VDD), D623.1 (VDD), D624.1 (VDD), D625.1 (VDD)
GND: C601.2, C602.2, C603.2, C604.2, C605.2, C606.2, C607.2, C608.2, C609.2, C610.2, C611.2, C612.2, C613.2, C614.2, C615.2, C616.2, C617.2, C618.2, C619.2, C620.2, C621.2, C622.2, C623.2, C624.2, C625.2, D601.3 (VSS), D602.3 (VSS), D603.3 (VSS), D604.3 (VSS), D605.3 (VSS), D606.3 (VSS), D607.3 (VSS), D608.3 (VSS), D609.3 (VSS), D610.3 (VSS), D611.3 (VSS), D612.3 (VSS), D613.3 (VSS), D614.3 (VSS), D615.3 (VSS), D616.3 (VSS), D617.3 (VSS), D618.3 (VSS), D619.3 (VSS), D620.3 (VSS), D621.3 (VSS), D622.3 (VSS), D623.3 (VSS), D624.3 (VSS), D625.3 (VSS)
MATRIX_DIN: D601.4 (DIN), TP601.1
MATRIX_DOUT: D625.2 (DOUT), TP602.1
unnamed: D601.2 (DOUT), D602.4 (DIN)
unnamed: D602.2 (DOUT), D603.4 (DIN)
unnamed: D603.2 (DOUT), D604.4 (DIN)
unnamed: D604.2 (DOUT), D605.4 (DIN)
unnamed: D605.2 (DOUT), D606.4 (DIN)
unnamed: D606.2 (DOUT), D607.4 (DIN)
unnamed: D607.2 (DOUT), D608.4 (DIN)
unnamed: D608.2 (DOUT), D609.4 (DIN)
unnamed: D609.2 (DOUT), D610.4 (DIN)
unnamed: D610.2 (DOUT), D611.4 (DIN)
unnamed: D611.2 (DOUT), D612.4 (DIN)
unnamed: D612.2 (DOUT), D613.4 (DIN)
unnamed: D613.2 (DOUT), D614.4 (DIN)
unnamed: D614.2 (DOUT), D615.4 (DIN)
unnamed: D615.2 (DOUT), D616.4 (DIN)
unnamed: D616.2 (DOUT), D617.4 (DIN)
unnamed: D617.2 (DOUT), D618.4 (DIN)
unnamed: D618.2 (DOUT), D619.4 (DIN)
unnamed: D619.2 (DOUT), D620.4 (DIN)
unnamed: D620.2 (DOUT), D621.4 (DIN)
unnamed: D621.2 (DOUT), D622.4 (DIN)
unnamed: D622.2 (DOUT), D623.4 (DIN)
unnamed: D623.2 (DOUT), D624.4 (DIN)
unnamed: D624.2 (DOUT), D625.4 (DIN)

Notes on the sheet:
Power regulation: https://learn.adafruit.com/sipping-power-with-neopixels/insights
5x5 individually addressable RGB LED Matrix (requires control through 1-wire WS2812 interface)
Datasheet: https://datasheet.lcsc.com/lcsc/1811151230_Worldsemi-WS2812E_C139127.pdf
Decoupling capacitors for 5x5 matrix (approximate current draw 20mA per LED)
