LuisErnie/Pico-Bot/KiCAD design files/mcu.kicad_sch

## KiCad design KiCAD design files/mcu.kicad_sch (2022-05-06)

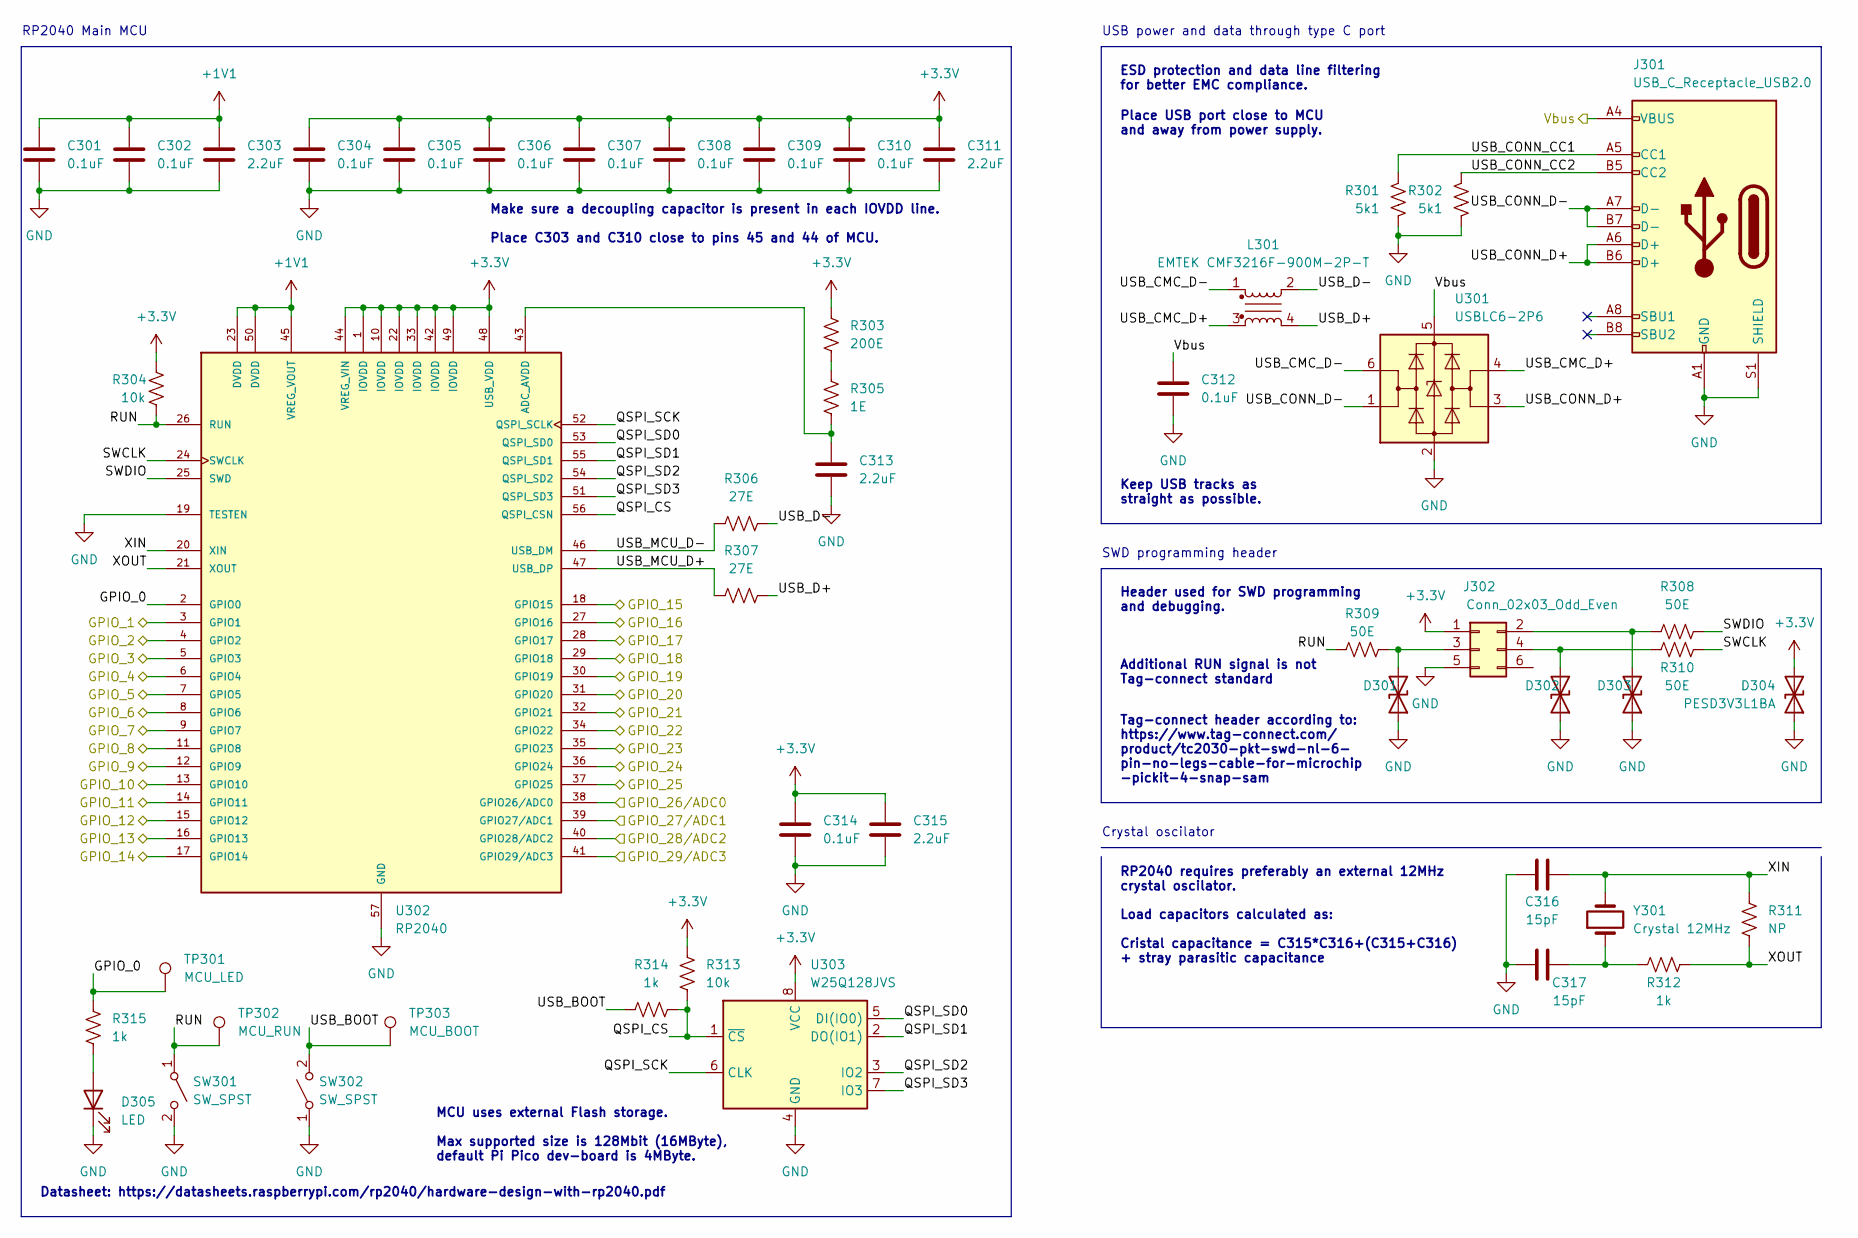
[picture p10: schematic mcu.kicad_sch]

Parts:
C301, C302, C304, C305, C306, C307, C308, C309, C310, C312, C314: 0.1uF; C_0402_1005Metric_Pad0.74x0.62mm_HandSolder
C303, C311, C313, C315: 2.2uF; C_0402_1005Metric_Pad0.74x0.62mm_HandSolder
C316, C317: 15pF; C_0402_1005Metric_Pad0.74x0.62mm_HandSolder
D301, D302, D303, D304: PESD3V3L1BA; D_SOD-323
D305: LED; LED_0805_2012Metric
J301: USB_C_Receptacle_USB2.0; USB_C_Receptacle_XKB_U262-16XN-4BVC11
J302: Conn_02x03_Odd_Even; Tag-Connect_TC2030-IDC-NL_2x03_P1.27mm_Vertical
L301: EMTEK CMF3216F-900M-2P-T; FIL_SRF3216-222Y
R301, R302: 5k1; R_0402_1005Metric_Pad0.72x0.64mm_HandSolder
R303: 200E; R_0402_1005Metric_Pad0.72x0.64mm_HandSolder
R304, R313: 10k; R_0402_1005Metric_Pad0.72x0.64mm_HandSolder
R305: 1E; R_0402_1005Metric_Pad0.72x0.64mm_HandSolder
R306, R307: 27E; R_0402_1005Metric_Pad0.72x0.64mm_HandSolder
R308, R309, R310: 50E; R_0402_1005Metric_Pad0.72x0.64mm_HandSolder
R311: NP; R_0603_1608Metric_Pad0.98x0.95mm_HandSolder
R312, R314, R315: 1k; R_0402_1005Metric_Pad0.72x0.64mm_HandSolder
SW301, SW302: SW_SPST; SW_SPST_TL3342
TP301: MCU_LED; TestPoint_Pad_D1.0mm
TP302: MCU_RUN; TestPoint_Pad_D1.0mm
TP303: MCU_BOOT; TestPoint_Pad_D1.0mm
U301: USBLC6-2P6; SOT-666
U302: RP2040; QFN40P700X700X90-57N; PARTREV 1.6.1
U303: W25Q128JVS; SOIC-8_5.23x5.23mm_P1.27mm
Y301: Crystal 12MHz; Crystal_SMD_5032-2Pin_5.0x3.2mm_HandSoldering

Connections:
+1V1: C301.1, C302.1, C303.1, U302.23 (DVDD), U302.45 (VREG_VOUT), U302.50 (DVDD)
+3.3V: C304.1, C305.1, C306.1, C307.1, C308.1, C309.1, C310.1, C311.1, C314.1, C315.1, D304.2 (A2), J302.1, R303.1, R304.1, R313.1, U302.1 (IOVDD), U302.10 (IOVDD), U302.22 (IOVDD), U302.33 (IOVDD), U302.42 (IOVDD), U302.44 (VREG_VIN), U302.48 (USB_VDD), U302.49 (IOVDD), U303.8 (VCC)
GND: C301.2, C302.2, C303.2, C304.2, C305.2, C306.2, C307.2, C308.2, C309.2, C310.2, C311.2, C312.2, C313.2, C314.2, C315.2, C316.1, C317.1, D301.1 (A1), D302.1 (A1), D303.1 (A1), D304.1 (A1), D305.1 (K), J301.A1 (GND), J301.A12 (GND), J301.B1 (GND), J301.B12 (GND), J301.S1 (SHIELD), J302.5, R301.2, R302.2, SW301.2 (B), SW302.1 (A), U301.2 (GND), U302.19 (TESTEN), U302.57 (GND), U303.4 (GND)
GPIO_0: R315.1, TP301.1, U302.2 (GPIO0)
GPIO_1: U302.3 (GPIO1)
GPIO_2: U302.4 (GPIO2)
GPIO_3: U302.5 (GPIO3)
GPIO_4: U302.6 (GPIO4)
GPIO_5: U302.7 (GPIO5)
GPIO_6: U302.8 (GPIO6)
GPIO_7: U302.9 (GPIO7)
GPIO_8: U302.11 (GPIO8)
GPIO_9: U302.12 (GPIO9)
GPIO_10: U302.13 (GPIO10)
GPIO_11: U302.14 (GPIO11)
GPIO_12: U302.15 (GPIO12)
GPIO_13: U302.16 (GPIO13)
GPIO_14: U302.17 (GPIO14)
GPIO_15: U302.18 (GPIO15)
GPIO_16: U302.27 (GPIO16)
GPIO_17: U302.28 (GPIO17)
GPIO_18: U302.29 (GPIO18)
GPIO_19: U302.30 (GPIO19)
GPIO_20: U302.31 (GPIO20)
GPIO_21: U302.32 (GPIO21)
GPIO_22: U302.34 (GPIO22)
GPIO_23: U302.35 (GPIO23)
GPIO_24: U302.36 (GPIO24)
GPIO_25: U302.37 (GPIO25)
GPIO_26/ADC0: U302.38 (GPIO26/ADC0)
GPIO_27/ADC1: U302.39 (GPIO27/ADC1)
GPIO_28/ADC2: U302.40 (GPIO28/ADC2)
GPIO_29/ADC3: U302.41 (GPIO29/ADC3)
unnamed: C313.1, R305.2, U302.43 (ADC_AVDD)
unnamed: C317.2, R312.1, Y301.1
unnamed: D301.2 (A2), J302.3, R309.2
unnamed: D302.2 (A2), J302.4, R310.1
unnamed: D303.2 (A2), J302.2, R308.1
unnamed: D305.2 (A), R315.2
unnamed: R303.2, R305.1
QSPI_CS: R313.2, R314.2, U302.56 (QSPI_CSN), U303.1 (~CS)
QSPI_SCK: U302.52 (QSPI_SCLK), U303.6 (CLK)
QSPI_SD0: U302.53 (QSPI_SD0), U303.5 (DI(IO0))
QSPI_SD1: U302.55 (QSPI_SD1), U303.2 (DO(IO1))
QSPI_SD2: U302.54 (QSPI_SD2), U303.3 (IO2)
QSPI_SD3: U302.51 (QSPI_SD3), U303.7 (IO3)
RUN: R304.2, R309.1, SW301.1 (A), TP302.1, U302.26 (RUN)
SWCLK: R310.2, U302.24 (SWCLK)
SWDIO: R308.2, U302.25 (SWD)
USB_BOOT: R314.1, SW302.2 (B), TP303.1
USB_CMC_D+: L301.3, U301.4 (I/O2)
USB_CMC_D-: L301.1, U301.6 (I/O1)
USB_CONN_CC1: J301.A5 (CC1), R301.1
USB_CONN_CC2: J301.B5 (CC2), R302.1
USB_CONN_D+: J301.A6 (D+), J301.B6 (D+), U301.3 (I/O2)
USB_CONN_D-: J301.A7 (D-), J301.B7 (D-), U301.1 (I/O1)
USB_D+: L301.4, R307.2
USB_D-: L301.2, R306.2
USB_MCU_D+: R307.1, U302.47 (USB_DP)
USB_MCU_D-: R306.1, U302.46 (USB_DM)
Vbus: C312.1, J301.A4 (VBUS), J301.A9 (VBUS), J301.B4 (VBUS), J301.B9 (VBUS), U301.5 (VBUS)
XIN: C316.2, R311.2, U302.20 (XIN), Y301.2
XOUT: R311.1, R312.2, U302.21 (XOUT)

Notes on the sheet:
Place USB port close to MCU and away from power supply.
ESD protection and data line filtering for better EMC compliance.
RP2040 requires preferably an external 12MHz crystal oscilator.
RP2040 Main MCU
Load capacitors calculated as: Cristal capacitance = C315*C316+(C315+C316) + stray parasitic capacitance
Make sure a decoupling capacitor is present in each IOVDD line. Place C303 and C310 close to pins 45 and 44 of MCU.
SWD programming header
USB power and data through type C port
Datasheet: https://datasheets.raspberrypi.com/rp2040/hardware-design-with-rp2040.pdf
Keep USB tracks as straight as possible.
Crystal oscilator
Tag-connect header according to: https://www.tag-connect.com/ product/tc2030-pkt-swd-nl-6- pin-no-legs-cable-for-microchip -pickit-4-snap-sam
Header used for SWD programming and debugging. Additional RUN signal is not Tag-connect standard
MCU uses external Flash storage. Max supported size is 128Mbit (16MByte), default Pi Pico dev-board is 4MByte.
