LuisErnie/Pico-Bot/KiCAD design files/motor.kicad_sch

## KiCad design KiCAD design files/motor.kicad_sch (2022-05-06)

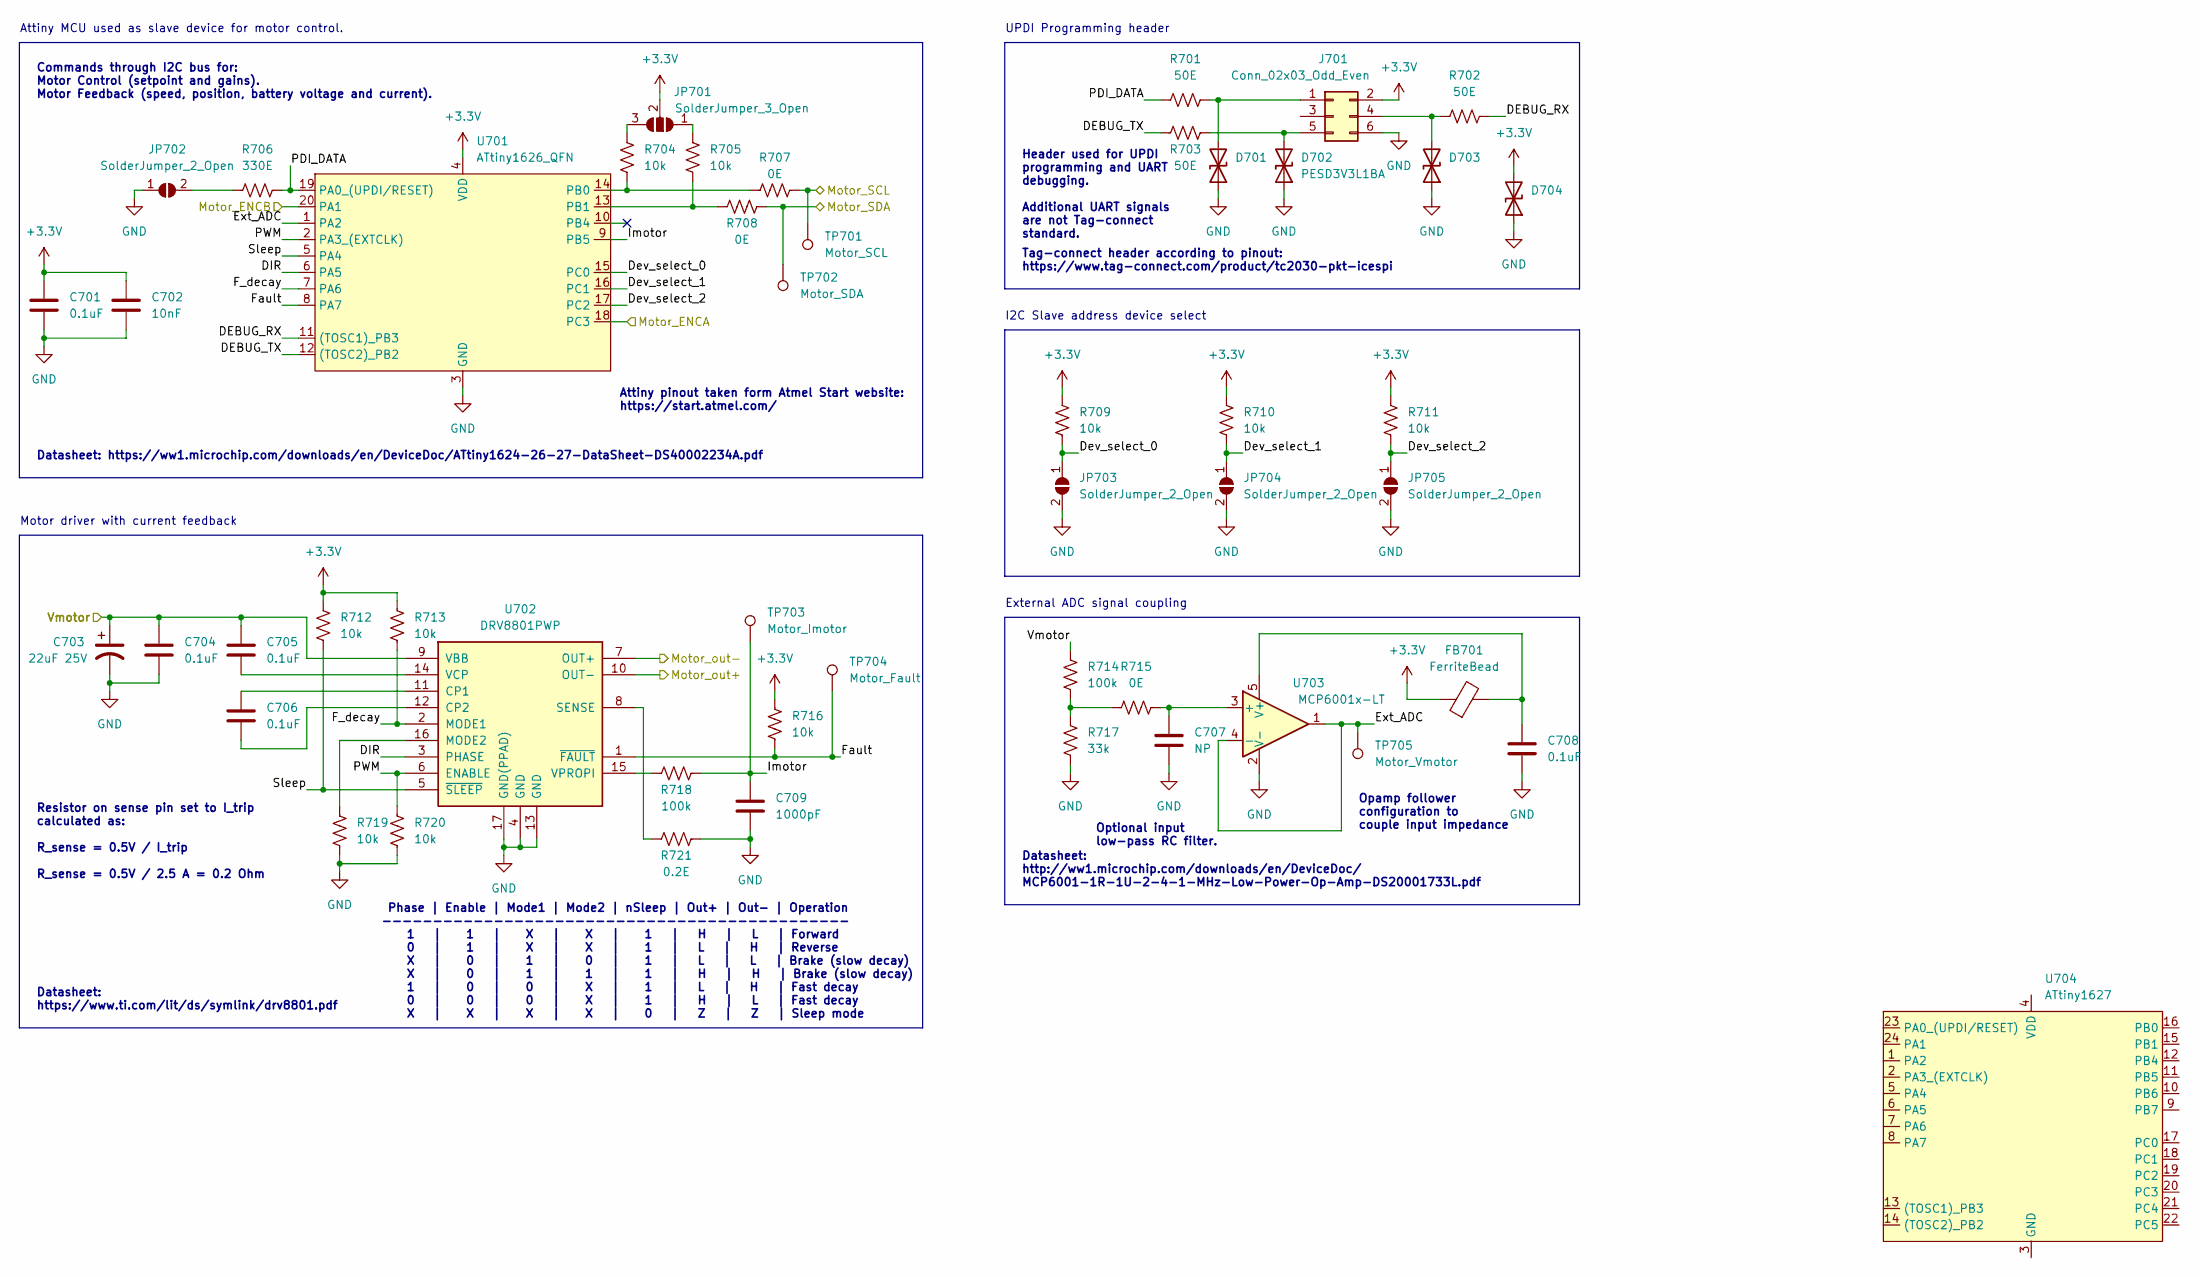
[picture p11: schematic motor.kicad_sch]

Parts:
C701, C704, C705, C706, C708: 0.1uF; C_0402_1005Metric_Pad0.74x0.62mm_HandSolder
C702: 10nF; C_0402_1005Metric_Pad0.74x0.62mm_HandSolder
C703: 22uF 25V; CP_Elec_4x5.4
C707: NP; C_0603_1608Metric_Pad1.08x0.95mm_HandSolder
C709: 1000pF; C_0402_1005Metric_Pad0.74x0.62mm_HandSolder
D701, D702, D703, D704: PESD3V3L1BA; D_SOD-323
FB701: FerriteBead; L_0805_2012Metric
J701: Conn_02x03_Odd_Even; Tag-Connect_TC2030-IDC-NL_2x03_P1.27mm_Vertical
JP701: SolderJumper_3_Open; SolderJumper-3_P1.3mm_Open_RoundedPad1.0x1.5mm
JP702, JP703, JP704, JP705: SolderJumper_2_Open; SolderJumper-2_P1.3mm_Open_RoundedPad1.0x1.5mm
R701, R702, R703: 50E; R_0402_1005Metric_Pad0.72x0.64mm_HandSolder
R704, R705, R709, R710, R711, R712, R713, R716, R719, R720: 10k; R_0402_1005Metric_Pad0.72x0.64mm_HandSolder
R706: 330E; R_0402_1005Metric_Pad0.72x0.64mm_HandSolder
R707, R708, R715: 0E; R_0402_1005Metric_Pad0.72x0.64mm_HandSolder
R714, R718: 100k; R_0402_1005Metric_Pad0.72x0.64mm_HandSolder
R717: 33k; R_0402_1005Metric_Pad0.72x0.64mm_HandSolder
R721: 0.2E; R_0402_1005Metric_Pad0.72x0.64mm_HandSolder
TP701: Motor_SCL; TestPoint_Pad_D1.0mm
TP702: Motor_SDA; TestPoint_Pad_D1.0mm
TP703: Motor_Imotor; TestPoint_Pad_D1.0mm
TP704: Motor_Fault; TestPoint_Pad_D1.0mm
TP705: Motor_Vmotor; TestPoint_Pad_D1.0mm
U701: ATtiny1626_QFN; UQFN-20_3x3mm_P0.4mm
U702: DRV8801PWP; HTSSOP-16-1EP_4.4x5mm_P0.65mm_EP3.4x5mm_Mask3x3mm_ThermalVi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
U703: MCP6001x-LT; SOT-23-5_HandSoldering
U704: ATtiny1627; QFN-24-1EP_4x4mm_P0.5mm_EP2.6x2.6mm

Connections:
+3.3V: C701.1, C702.1, D704.2 (A2), FB701.1, J701.2, JP701.2 (C), R709.1, R710.1, R711.1, R712.1, R713.1, R716.1, U701.4 (VDD)
DEBUG_RX: R702.2, U701.11 ((TOSC1)_PB3)
DEBUG_TX: R703.1, U701.12 ((TOSC2)_PB2)
DIR: U701.6 (PA5), U702.3 (PHASE)
Dev_select_0: JP703.1 (A), R709.2, U701.15 (PC0)
Dev_select_1: JP704.1 (A), R710.2, U701.16 (PC1)
Dev_select_2: JP705.1 (A), R711.2, U701.17 (PC2)
Ext_ADC: TP705.1, U701.1 (PA2), U703.1, U703.4 (-)
F_decay: R713.2, U701.7 (PA6), U702.2 (MODE1)
Fault: R716.2, TP704.1, U701.8 (PA7), U702.1 (~FAULT)
GND: C701.2, C702.2, C703.2, C704.2, C707.2, C708.2, C709.2, D701.1 (A1), D702.1 (A1), D703.1 (A1), D704.1 (A1), J701.6, JP702.1 (A), JP703.2 (B), JP704.2 (B), JP705.2 (B), R717.2, R719.2, R720.2, R721.2, U701.3 (GND), U702.4 (GND), U702.13 (GND), U702.17 (GND(PPAD)), U703.2 (V-)
Imotor: C709.1, R718.2, TP703.1, U701.9 (PB5)
Motor_ENCA: U701.18 (PC3)
Motor_ENCB: U701.20 (PA1)
Motor_SCL: R707.1, TP701.1
Motor_SDA: R708.1, TP702.1
Motor_out+: U702.10 (OUT-)
Motor_out-: U702.7 (OUT+)
unnamed: C705.2, U702.14 (VCP)
unnamed: C706.1, U702.11 (CP1)
unnamed: C706.2, U702.12 (CP2)
unnamed: C707.1, R715.2, U703.3 (+)
unnamed: C708.1, FB701.2, U703.5 (V+)
unnamed: D701.2 (A2), J701.1, R701.2
unnamed: D702.2 (A2), J701.5, R703.2
unnamed: D703.2 (A2), J701.4, R702.1
unnamed: JP701.1 (A), R705.1
unnamed: JP701.3 (B), R704.1
unnamed: JP702.2 (B), R706.1
unnamed: R704.2, R707.2, U701.14 (PB0)
unnamed: R705.2, R708.2, U701.13 (PB1)
unnamed: R714.2, R715.1, R717.1
unnamed: R718.1, U702.15 (VPROPI)
unnamed: R719.1, U702.16 (MODE2)
unnamed: R721.1, U702.8 (SENSE)
PDI_DATA: R701.1, R706.2, U701.19 (PA0_(UPDI/RESET))
PWM: R720.1, U701.2 (PA3_(EXTCLK)), U702.6 (ENABLE)
Sleep: R712.2, U701.5 (PA4), U702.5 (~SLEEP)
Vmotor: C703.1, C704.1, C705.1, R714.1, U702.9 (VBB)

Notes on the sheet:
Resistor on sense pin set to I_trip calculated as: R_sense = 0.5V / I_trip R_sense = 0.5V / 2.5 A = 0.2 Ohm
Phase | Enable | Mode1 | Mode2 | nSleep | Out+ | Out- | Operation ---------------------------------------------- 1 | 1 | X | X | 1 | H | L | Forward 0 | 1 | X | X | 1 | L | H | Reverse X | 0 | 1 | 0 | 1 | L | L | Brake (slow decay) X | 0 | 1 | 1 | 1 | H | H | Brake (slow decay) 1 | 0 | 0 | X | 1 | 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
Opamp follower configuration to couple input impedance
Datasheet: https://ww1.microchip.com/downloads/en/DeviceDoc/ATtiny1624-26-27-DataSheet-DS40002234A.pdf
Attiny MCU used as slave device for motor control.
Commands through I2C bus for: Motor Control (setpoint and gains). Motor Feedback (speed, position, battery voltage and current).
Attiny pinout taken form Atmel Start website: https://start.atmel.com/
Tag-connect header according to pinout: https://www.tag-connect.com/product/tc2030-pkt-icespi
Optional input low-pass RC filter.
I2C Slave address device select
External ADC signal coupling
Header used for UPDI programming and UART debugging. Additional UART signals are not Tag-connect standard.
Datasheet: https://www.ti.com/lit/ds/symlink/drv8801.pdf
Motor driver with current feedback
UPDI Programming header
Datasheet: http://ww1.microchip.com/downloads/en/DeviceDoc/ MCP6001-1R-1U-2-4-1-MHz-Low-Power-Op-Amp-DS20001733L.pdf
