LuisErnie/Pico-Bot/KiCAD design files/motor_a.kicad_sch

## KiCad design KiCAD design files/motor_a.kicad_sch (2022-05-06)

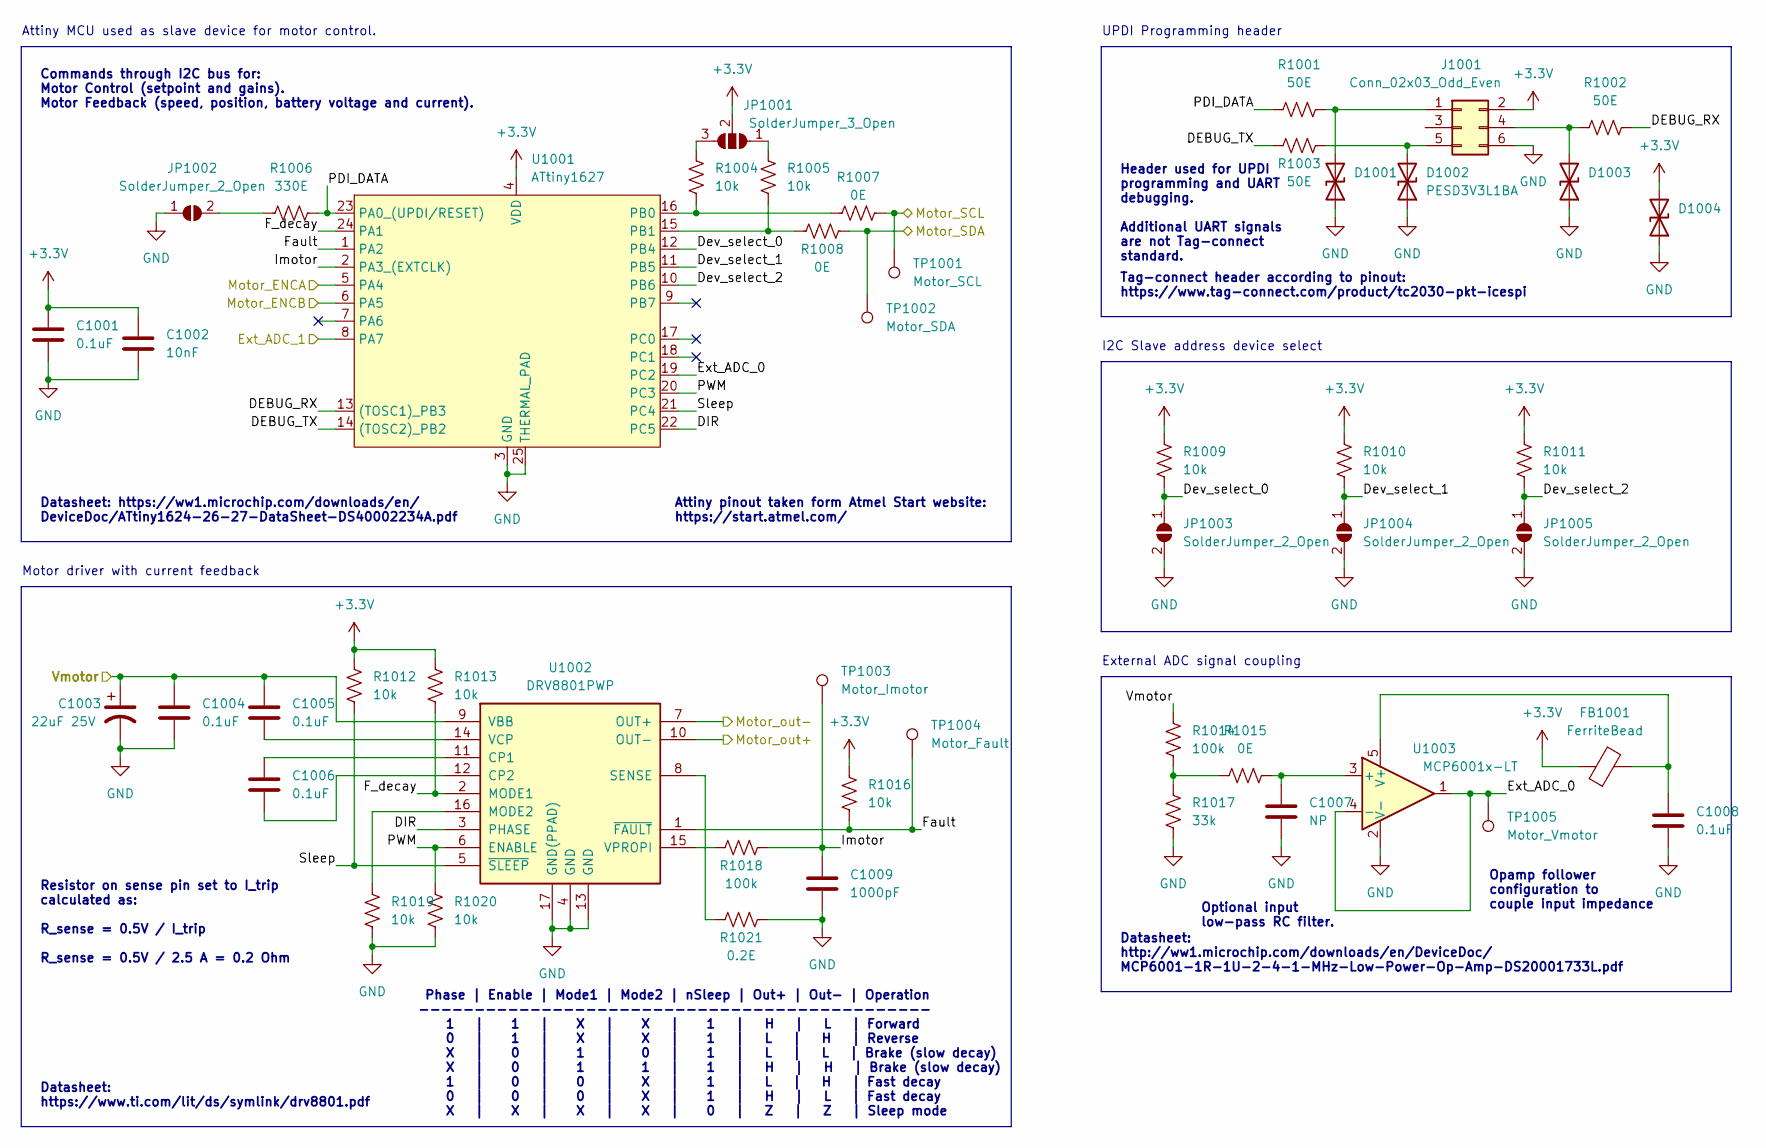
[picture p12: schematic motor_a.kicad_sch]

Parts:
C1001, C1004, C1005, C1006, C1008: 0.1uF; C_0402_1005Metric_Pad0.74x0.62mm_HandSolder
C1002: 10nF; C_0402_1005Metric_Pad0.74x0.62mm_HandSolder
C1003: 22uF 25V; CP_Elec_4x5.4
C1007: NP; C_0603_1608Metric_Pad1.08x0.95mm_HandSolder
C1009: 1000pF; C_0402_1005Metric_Pad0.74x0.62mm_HandSolder
D1001, D1002, D1003, D1004: PESD3V3L1BA; D_SOD-323
FB1001: FerriteBead; L_0805_2012Metric
J1001: Conn_02x03_Odd_Even; Tag-Connect_TC2030-IDC-NL_2x03_P1.27mm_Vertical
JP1001: SolderJumper_3_Open; SolderJumper-3_P1.3mm_Open_RoundedPad1.0x1.5mm
JP1002, JP1003, JP1004, JP1005: SolderJumper_2_Open; SolderJumper-2_P1.3mm_Open_RoundedPad1.0x1.5mm
R1001, R1002, R1003: 50E; R_0402_1005Metric_Pad0.72x0.64mm_HandSolder
R1004, R1005, R1009, R1010, R1011, R1012, R1013, R1016, R1019, R1020: 10k; R_0402_1005Metric_Pad0.72x0.64mm_HandSolder
R1006: 330E; R_0402_1005Metric_Pad0.72x0.64mm_HandSolder
R1007, R1008, R1015: 0E; R_0402_1005Metric_Pad0.72x0.64mm_HandSolder
R1014, R1018: 100k; R_0402_1005Metric_Pad0.72x0.64mm_HandSolder
R1017: 33k; R_0402_1005Metric_Pad0.72x0.64mm_HandSolder
R1021: 0.2E; R_0402_1005Metric_Pad0.72x0.64mm_HandSolder
TP1001: Motor_SCL; TestPoint_Pad_D1.0mm
TP1002: Motor_SDA; TestPoint_Pad_D1.0mm
TP1003: Motor_Imotor; TestPoint_Pad_D1.0mm
TP1004: Motor_Fault; TestPoint_Pad_D1.0mm
TP1005: Motor_Vmotor; TestPoint_Pad_D1.0mm
U1001: ATtiny1627; QFN-24-1EP_4x4mm_P0.5mm_EP2.7x2.7mm
U1002: DRV8801PWP; HTSSOP-16-1EP_4.4x5mm_P0.65mm_EP3.4x5mm_Mask3x3mm_ThermalVi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
U1003: MCP6001x-LT; SOT-23-5_HandSoldering

Connections:
+3.3V: C1001.1, C1002.1, D1004.2 (A2), FB1001.1, J1001.2, JP1001.2 (C), R1009.1, R1010.1, R1011.1, R1012.1, R1013.1, R1016.1, U1001.4 (VDD)
DEBUG_RX: R1002.2, U1001.13 ((TOSC1)_PB3)
DEBUG_TX: R1003.1, U1001.14 ((TOSC2)_PB2)
DIR: U1001.22 (PC5), U1002.3 (PHASE)
Dev_select_0: JP1003.1 (A), R1009.2, U1001.12 (PB4)
Dev_select_1: JP1004.1 (A), R1010.2, U1001.11 (PB5)
Dev_select_2: JP1005.1 (A), R1011.2, U1001.10 (PB6)
Ext_ADC_0: TP1005.1, U1001.19 (PC2), U1003.1, U1003.4 (-)
Ext_ADC_1: U1001.8 (PA7)
F_decay: R1013.2, U1001.24 (PA1), U1002.2 (MODE1)
Fault: R1016.2, TP1004.1, U1001.1 (PA2), U1002.1 (~FAULT)
GND: C1001.2, C1002.2, C1003.2, C1004.2, C1007.2, C1008.2, C1009.2, D1001.1 (A1), D1002.1 (A1), D1003.1 (A1), D1004.1 (A1), J1001.6, JP1002.1 (A), JP1003.2 (B), JP1004.2 (B), JP1005.2 (B), R1017.2, R1019.2, R1020.2, R1021.2, U1001.3 (GND), U1001.25 (THERMAL_PAD), U1002.4 (GND), U1002.13 (GND), U1002.17 (GND(PPAD)), U1003.2 (V-)
Imotor: C1009.1, R1018.2, TP1003.1, U1001.2 (PA3_(EXTCLK))
Motor_ENCA: U1001.5 (PA4)
Motor_ENCB: U1001.6 (PA5)
Motor_SCL: R1007.1, TP1001.1
Motor_SDA: R1008.1, TP1002.1
Motor_out+: U1002.10 (OUT-)
Motor_out-: U1002.7 (OUT+)
unnamed: C1005.2, U1002.14 (VCP)
unnamed: C1006.1, U1002.11 (CP1)
unnamed: C1006.2, U1002.12 (CP2)
unnamed: C1007.1, R1015.2, U1003.3 (+)
unnamed: C1008.1, FB1001.2, U1003.5 (V+)
unnamed: D1001.2 (A2), J1001.1, R1001.2
unnamed: D1002.2 (A2), J1001.5, R1003.2
unnamed: D1003.2 (A2), J1001.4, R1002.1
unnamed: JP1001.1 (A), R1005.1
unnamed: JP1001.3 (B), R1004.1
unnamed: JP1002.2 (B), R1006.1
unnamed: R1004.2, R1007.2, U1001.16 (PB0)
unnamed: R1005.2, R1008.2, U1001.15 (PB1)
unnamed: R1014.2, R1015.1, R1017.1
unnamed: R1018.1, U1002.15 (VPROPI)
unnamed: R1019.1, U1002.16 (MODE2)
unnamed: R1021.1, U1002.8 (SENSE)
PDI_DATA: R1001.1, R1006.2, U1001.23 (PA0_(UPDI/RESET))
PWM: R1020.1, U1001.20 (PC3), U1002.6 (ENABLE)
Sleep: R1012.2, U1001.21 (PC4), U1002.5 (~SLEEP)
Vmotor: C1003.1, C1004.1, C1005.1, R1014.1, U1002.9 (VBB)

Notes on the sheet:
Resistor on sense pin set to I_trip calculated as: R_sense = 0.5V / I_trip R_sense = 0.5V / 2.5 A = 0.2 Ohm
Phase | Enable | Mode1 | Mode2 | nSleep | Out+ | Out- | Operation ---------------------------------------------- 1 | 1 | X | X | 1 | H | L | Forward 0 | 1 | X | X | 1 | L | H | Reverse X | 0 | 1 | 0 | 1 | L | L | Brake (slow decay) X | 0 | 1 | 1 | 1 | H | H | Brake (slow decay) 1 | 0 | 0 | X | 1 | 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
Opamp follower configuration to couple input impedance
Commands through I2C bus for: Motor Control (setpoint and gains). Motor Feedback (speed, position, battery voltage and current).
Datasheet: https://ww1.microchip.com/downloads/en/ DeviceDoc/ATtiny1624-26-27-DataSheet-DS40002234A.pdf
Attiny pinout taken form Atmel Start website: https://start.atmel.com/
Tag-connect header according to pinout: https://www.tag-connect.com/product/tc2030-pkt-icespi
Optional input low-pass RC filter.
I2C Slave address device select
External ADC signal coupling
Header used for UPDI programming and UART debugging. Additional UART signals are not Tag-connect standard.
Datasheet: https://www.ti.com/lit/ds/symlink/drv8801.pdf
Motor driver with current feedback
UPDI Programming header
Attiny MCU used as slave device for motor control.
Datasheet: http://ww1.microchip.com/downloads/en/DeviceDoc/ MCP6001-1R-1U-2-4-1-MHz-Low-Power-Op-Amp-DS20001733L.pdf
