LuisErnie/Pico-Bot/KiCAD design files/power.kicad_sch

## KiCad design KiCAD design files/power.kicad_sch (2022-05-06)

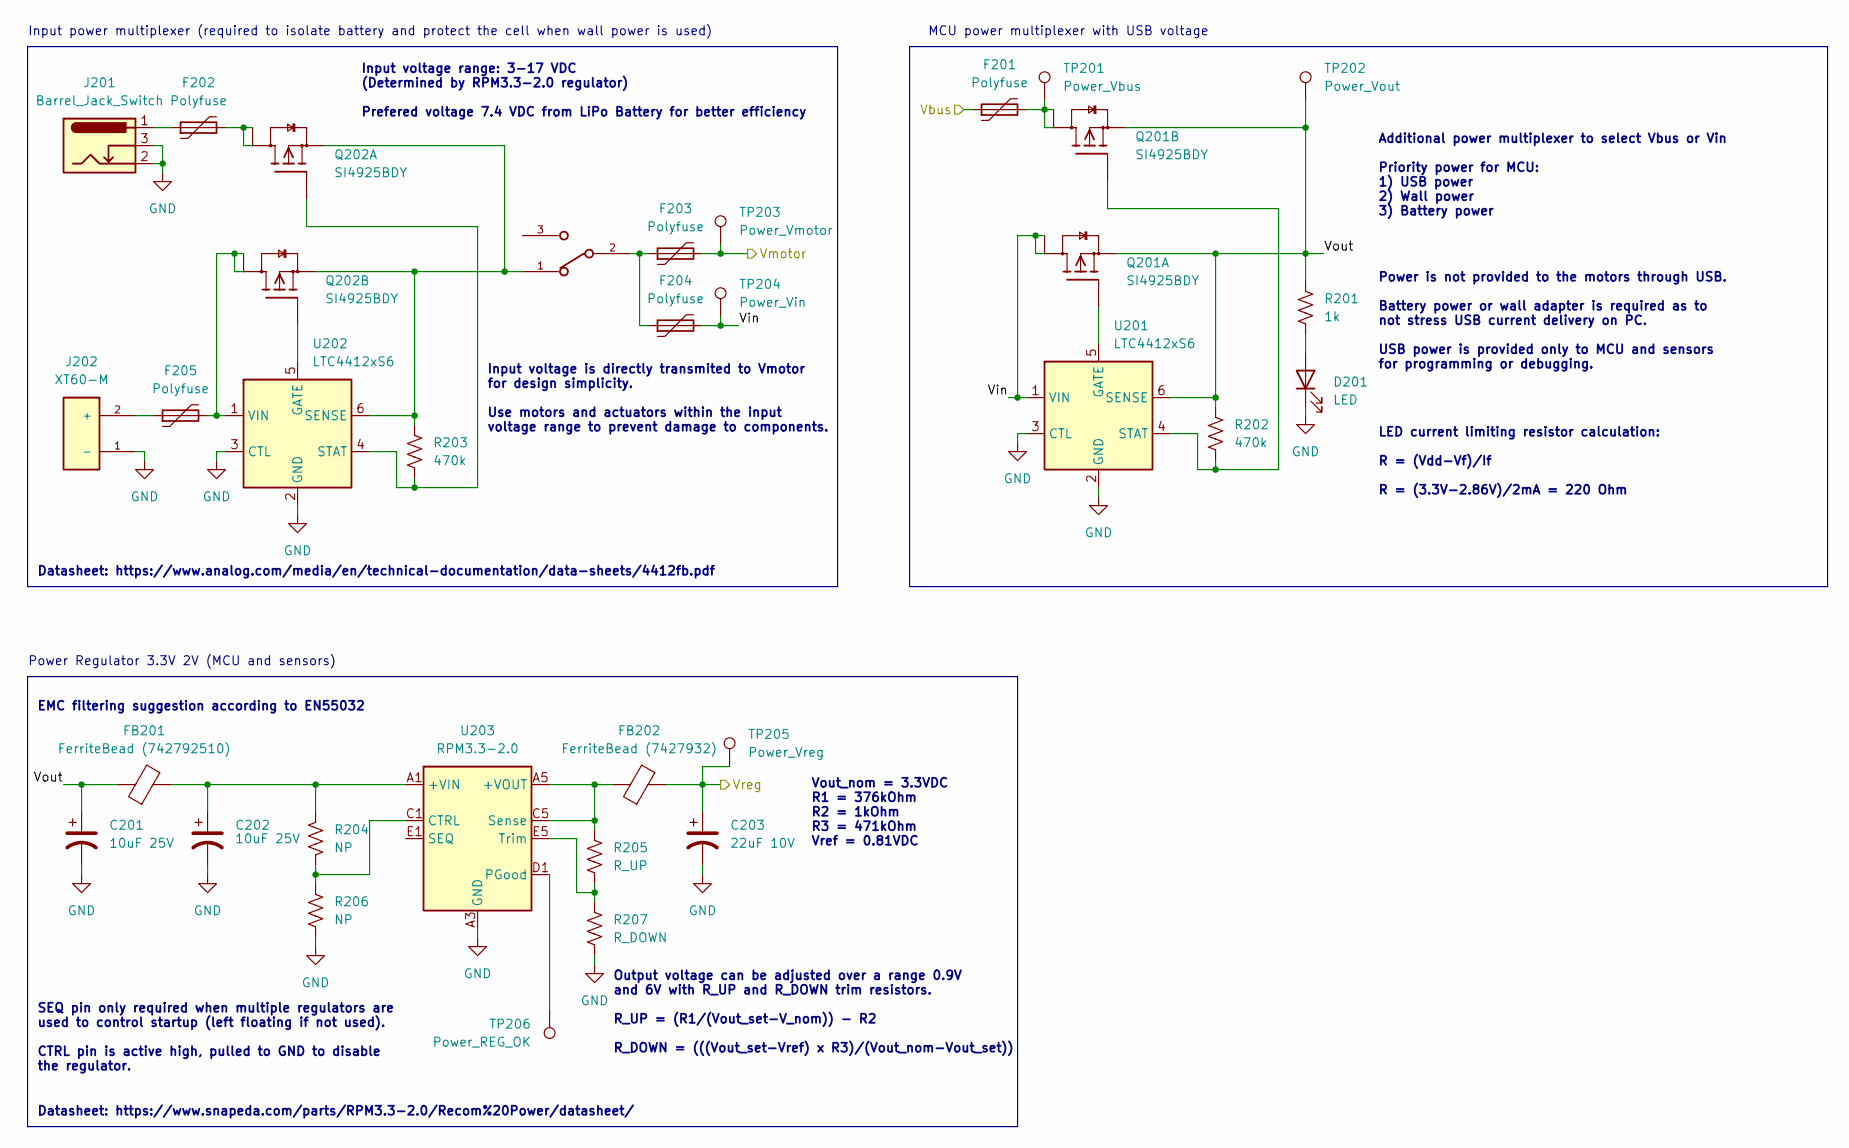
[picture p13: schematic power.kicad_sch]

Parts:
C201, C202: 10uF 25V; CP_Elec_4x5.4
C203: 22uF 10V; CP_Elec_6.3x5.4
D201: LED; LED_0805_2012Metric
F201, F202, F203, F204, F205: Polyfuse; Fuse_1812_4532Metric
FB201: FerriteBead (742792510); L_1812_4532Metric
FB202: FerriteBead (7427932); L_1812_4532Metric
J201: Barrel_Jack_Switch; BarrelJack_CLIFF_FC681465S_SMT_Horizontal
J202: XT60-M; AMASS_XT60-M; PARTREV 1.2
Q201, Q202: SI4925BDY; SO-8
R201: 1k; R_0402_1005Metric_Pad0.72x0.64mm_HandSolder
R202, R203: 470k; R_0402_1005Metric_Pad0.72x0.64mm_HandSolder
R204, R206: NP; R_0603_1608Metric_Pad0.98x0.95mm_HandSolder
R205: R_UP; R_0603_1608Metric_Pad0.98x0.95mm_HandSolder
R207: R_DOWN; R_0603_1608Metric_Pad0.98x0.95mm_HandSolder
S201: EG1213; SW_EG1213
TP201: Power_Vbus; TestPoint_Pad_D1.0mm
TP202: Power_Vout; TestPoint_Pad_D1.0mm
TP203: Power_Vmotor; TestPoint_Pad_D1.0mm
TP204: Power_Vin; TestPoint_Pad_D1.0mm
TP205: Power_Vreg; TestPoint_Pad_D1.0mm
TP206: Power_REG_OK; TestPoint_Pad_D1.0mm
U201, U202: LTC4412xS6; TSOT-23-6
U203: RPM3.3-2.0; Converter_DCDC_RECOM_RPMx.x-x.0

Connections:
GND: C201.2, C202.2, C203.2, D201.1 (K), J201.2, J201.3, J202.1 (-), R206.2, R207.2, U201.2 (GND), U201.3 (CTL), U202.2 (GND), U202.3 (CTL), U203.A3 (GND), U203.A4 (GND), U203.B1 (GND), U203.B2 (GND), U203.B3 (GND), U203.B4 (GND), U203.C2 (GND), U203.C3 (GND), U203.C4 (GND), U203.D2 (GND), U203.D3 (GND), U203.D4 (GND), U203.D5 (GND), U203.E3 (GND), U203.E4 (GND)
unnamed: C202.1, FB201.2, R204.1, U203.A1 (+VIN), U203.A2 (+VIN)
unnamed: D201.2 (A), R201.2
unnamed: F201.2, Q201.5, Q201.6, TP201.1
unnamed: F202.1, J201.1
unnamed: F202.2, Q202.7, Q202.8
unnamed: F203.1, F204.1, S201.2
unnamed: F205.1, J202.2 (+)
unnamed: F205.2, Q202.5, Q202.6, U202.1 (VIN)
unnamed: FB202.1, R205.1, U203.A5 (+VOUT), U203.B5 (+VOUT), U203.C5 (Sense)
unnamed: Q201.2, U201.5 (GATE)
unnamed: Q201.4, R202.2, U201.4 (STAT)
unnamed: Q202.1, Q202.3, R203.1, S201.1, U202.6 (SENSE)
unnamed: Q202.2, R203.2, U202.4 (STAT)
unnamed: Q202.4, U202.5 (GATE)
unnamed: R204.2, R206.1, U203.C1 (CTRL)
unnamed: R205.2, R207.1, U203.E5 (Trim)
unnamed: TP206.1, U203.D1 (PGood)
Vbus: F201.1
Vin: F204.2, Q201.7, Q201.8, TP204.1, U201.1 (VIN)
Vmotor: F203.2, TP203.1
Vout: C201.1, FB201.1, Q201.1, Q201.3, R201.1, R202.1, TP202.1, U201.6 (SENSE)
Vreg: C203.1, FB202.2, TP205.1

Notes on the sheet:
Vout_nom = 3.3VDC R1 = 376kOhm R2 = 1kOhm R3 = 471kOhm Vref = 0.81VDC
Power Regulator 3.3V 2V (MCU and sensors)
Datasheet: https://www.analog.com/media/en/technical-documentation/data-sheets/4412fb.pdf
Output voltage can be adjusted over a range 0.9V and 6V with R_UP and R_DOWN trim resistors. R_UP = (R1/(Vout_set-V_nom)) - R2 R_DOWN = (((Vout_set-Vref) x R3)/(Vout_nom-Vout_set))
Datasheet: https://www.snapeda.com/parts/RPM3.3-2.0/Recom%20Power/datasheet/
Power is not provided to the motors through USB. Battery power or wall adapter is required as to not stress USB current delivery on PC. USB power is provided only to MCU and sensors for programming or debugging.
MCU power multiplexer with USB voltage
Input voltage is directly transmited to Vmotor for design simplicity. Use motors and actuators within the input voltage range to prevent damage to components.
SEQ pin only required when multiple regulators are used to control startup (left floating if not used). CTRL pin is active high, pulled to GND to disable the regulator.
EMC filtering suggestion according to EN55032
Input power multiplexer (required to isolate battery and protect the cell when wall power is used)
LED current limiting resistor calculation: R = (Vdd-Vf)/If R = (3.3V-2.86V)/2mA = 220 Ohm
Additional power multiplexer to select Vbus or Vin Priority power for MCU: 1) USB power 2) Wall power 3) Battery power
Input voltage range: 3-17 VDC (Determined by RPM3.3-2.0 regulator) Prefered voltage 7.4 VDC from LiPo Battery for better efficiency
