LuisErnie/Pico-Bot/KiCAD design files/rpi_header.kicad_sch

## KiCad design KiCAD design files/rpi_header.kicad_sch (2022-05-06)

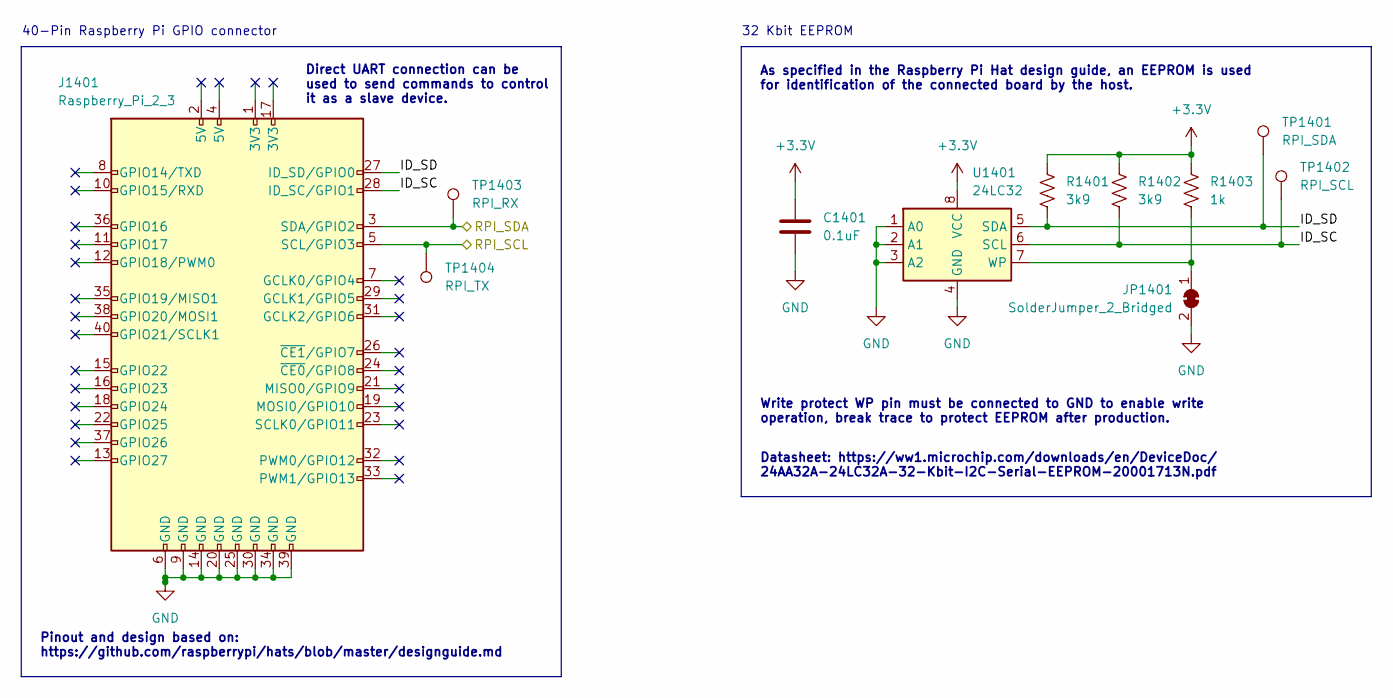
[picture p14: schematic rpi_header.kicad_sch]

Parts:
C1401: 0.1uF; C_0402_1005Metric_Pad0.74x0.62mm_HandSolder
J1401: Raspberry_Pi_2_3; PinHeader_2x20_P2.54mm_Vertical_SMD
JP1401: SolderJumper_2_Bridged; SolderJumper-2_P1.3mm_Bridged_RoundedPad1.0x1.5mm
R1401, R1402: 3k9; R_0402_1005Metric_Pad0.72x0.64mm_HandSolder
R1403: 1k; R_0402_1005Metric_Pad0.72x0.64mm_HandSolder
TP1401: RPI_SDA; TestPoint_Pad_D1.0mm
TP1402: RPI_SCL; TestPoint_Pad_D1.0mm
TP1403: RPI_RX; TestPoint_Pad_D1.0mm
TP1404: RPI_TX; TestPoint_Pad_D1.0mm
U1401: 24LC32; TSSOP-8_4.4x3mm_P0.65mm

Connections:
+3.3V: C1401.1, R1401.1, R1402.1, R1403.1, U1401.8 (VCC)
GND: C1401.2, J1401.6 (GND), J1401.9 (GND), J1401.14 (GND), J1401.20 (GND), J1401.25 (GND), J1401.30 (GND), J1401.34 (GND), J1401.39 (GND), JP1401.2 (B), U1401.1 (A0), U1401.2 (A1), U1401.3 (A2), U1401.4 (GND)
ID_SC: J1401.28 (ID_SC/GPIO1), R1402.2, TP1402.1, U1401.6 (SCL)
ID_SD: J1401.27 (ID_SD/GPIO0), R1401.2, TP1401.1, U1401.5 (SDA)
unnamed: JP1401.1 (A), R1403.2, U1401.7 (WP)
RPI_SCL: J1401.5 (SCL/GPIO3), TP1404.1
RPI_SDA: J1401.3 (SDA/GPIO2), TP1403.1

Notes on the sheet:
Direct UART connection can be used to send commands to control it as a slave device.
Pinout and design based on: https://github.com/raspberrypi/hats/blob/master/designguide.md
32 Kbit EEPROM
Datasheet: https://ww1.microchip.com/downloads/en/DeviceDoc/ 24AA32A-24LC32A-32-Kbit-I2C-Serial-EEPROM-20001713N.pdf
40-Pin Raspberry Pi GPIO connector
As specified in the Raspberry Pi Hat design guide, an EEPROM is used for identification of the connected board by the host.
Write protect WP pin must be connected to GND to enable write operation, break trace to protect EEPROM after production.
