LuisErnie/Pico-Bot/KiCAD design files/sound.kicad_sch

## KiCad design KiCAD design files/sound.kicad_sch (2022-05-06)

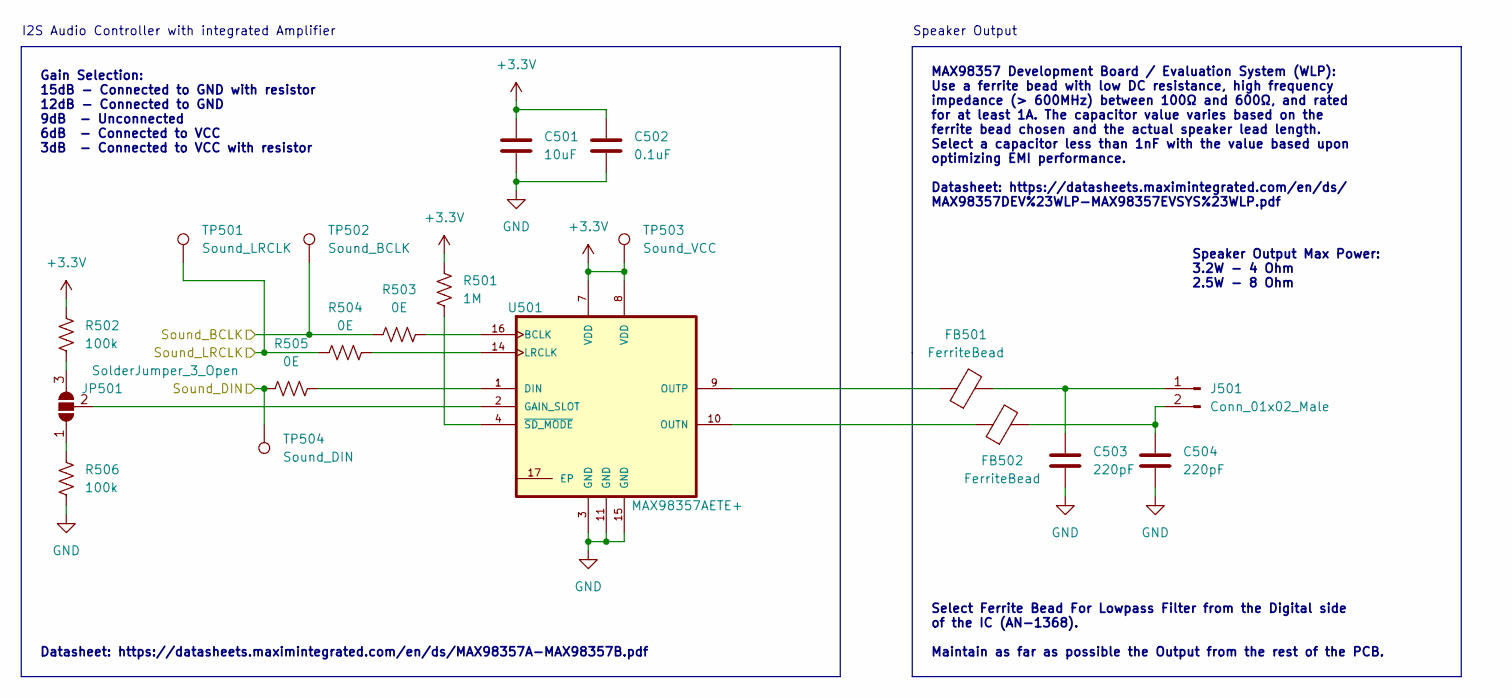
[picture p15: schematic sound.kicad_sch]

Parts:
C501: 10uF; C_0402_1005Metric_Pad0.74x0.62mm_HandSolder
C502: 0.1uF; C_0402_1005Metric_Pad0.74x0.62mm_HandSolder
C503, C504: 220pF; C_0402_1005Metric_Pad0.74x0.62mm_HandSolder
FB501, FB502: FerriteBead; L_0805_2012Metric
J501: Conn_01x02_Male; JST_XH_B2B-XH-A_1x02_P2.50mm_Vertical
JP501: SolderJumper_3_Open; SolderJumper-3_P1.3mm_Open_RoundedPad1.0x1.5mm
R501: 1M; R_0402_1005Metric_Pad0.72x0.64mm_HandSolder
R502, R506: 100k; R_0402_1005Metric_Pad0.72x0.64mm_HandSolder
R503, R504, R505: 0E; R_0402_1005Metric_Pad0.72x0.64mm_HandSolder
TP501: Sound_LRCLK; TestPoint_Pad_D1.0mm
TP502: Sound_BCLK; TestPoint_Pad_D1.0mm
TP503: Sound_VCC; TestPoint_Pad_D1.0mm
TP504: Sound_DIN; TestPoint_Pad_D1.0mm
U501: MAX98357AETE+; QFN50P300X300X80-17N

Connections:
+3.3V: C501.1, C502.1, R501.1, R502.1, TP503.1, U501.7 (VDD), U501.8 (VDD)
GND: C501.2, C502.2, C503.2, C504.2, R506.2, U501.3 (GND), U501.11 (GND), U501.15 (GND)
unnamed: C503.1, FB501.2, J501.1
unnamed: C504.1, FB502.2, J501.2
unnamed: FB501.1, U501.9 (OUTP)
unnamed: FB502.1, U501.10 (OUTN)
unnamed: JP501.1 (A), R506.1
unnamed: JP501.2 (C), U501.2 (GAIN_SLOT)
unnamed: JP501.3 (B), R502.2
unnamed: R501.2, U501.4 (~SD_MODE)
unnamed: R503.1, U501.16 (BCLK)
unnamed: R504.1, U501.14 (LRCLK)
unnamed: R505.1, U501.1 (DIN)
Sound_BCLK: R503.2, TP502.1
Sound_DIN: R505.2, TP504.1
Sound_LRCLK: R504.2, TP501.1

Notes on the sheet:
Speaker Output Max Power: 3.2W - 4 Ohm 2.5W - 8 Ohm
MAX98357 Development Board / Evaluation System (WLP): Use a ferrite bead with low DC resistance, high frequency impedance (> 600MHz) between 100Ω and 600Ω, and rated for at least 1A. The capacitor value varies based on the ferrite bead chosen and the actual speaker lead length. Select a capacitor l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
Datasheet: https://datasheets.maximintegrated.com/en/ds/MAX98357A-MAX98357B.pdf
I2S Audio Controller with integrated Amplifier
Gain Selection: 15dB - Connected to GND with resistor 12dB - Connected to GND 9dB - Unconnected 6dB - Connected to VCC 3dB - Connected to VCC with resistor
Speaker Output
Select Ferrite Bead For Lowpass Filter from the Digital side of the IC (AN-1368). Maintain as far as possible the Output from the rest of the PCB.
