LuisErnie/Pico-Bot/(commit log)

2022-05-06 Initial commit of the REV A design files
    [BOM.xlsx, PicoBot.kicad_sch, adc.kicad_sch, connectors.kicad_sch, imu.kicad_sch, led_matrix.kicad_sch, mcu.kicad_sch, motor.kicad_sch]
2022-05-06 Manufacturing files used for first prototype
