LuisErnie/Pico-Bot/(notices)

Notices in the files:
KiCAD design files/sound.kicad_sch:
Distributed Open-source as: CC BY-SA 4.0
